autosolutionsai-didac/tiny-engineer/hardware/README.md

# Hardware (PCB)

KiCad PCB projects for Tiny Engineer.

Boards live under `boards/<board-name>/`. Prefer the same name for the directory and the KiCad project.

| Board | Role |
| --- | --- |
| [`main-control-board`](boards/main-control-board/) | Draft interconnect / carrier (header sockets for existing modules) |
| [`xiao-main-board`](boards/xiao-main-board/) | Draft carrier for the Seeed XIAO ESP32S3 build (70 × 45 mm): sockets for XIAO, PCA9685, MAX98357A, OLED, 5993 power input; buffered WS2812 output |

Contribution rules, KiCad version, what to commit, ERC/DRC, and PR expectations: [docs/pcb.md](../docs/pcb.md). Pre-PR checklist: [docs/pcb.md#checklist](../docs/pcb.md#checklist). Critical net checklist: [docs/pcb.md#expected-nets-yml](../docs/pcb.md#expected-nets-yml). Local/CI checks: `python3 scripts/check_pcb.py` (KiCad 10) — [docs/testing.md](../docs/testing.md).

This tree is KiCad source only. Robot electrical reference (pinout, wiring, BOM) is [`docs/hardware/`](../docs/hardware/README.md). Firmware drivers are `src/hardware/`.

## License

Board sources in `boards/` are [CERN-OHL-S-2.0](LICENSE). See [NOTICE](NOTICE) for copyright, Source Location, and product notice requirements.

This README is software documentation and remains under the MIT License — [LICENSING.md](../LICENSING.md).

The **Tiny Engineer** name and logo are not licensed — [TRADEMARK.md](../TRADEMARK.md).
