autosolutionsai-didac/tiny-engineer/3d_models/README.md

# 3D models

Printable parts and source CAD for the Vibe Bot desk robot, based on the Tiny Engineer open hardware design by Krzysztof Jamroz (upstream Source Location: https://github.com/jamro/tiny-engineer/tree/main/3d_models — see [NOTICE](NOTICE)).

## CAD TODO (Vibe Bot)

The CAD in this folder is still the upstream Tiny Engineer design. Before Vibe Bot ships its own printables, the following must be done **in Autodesk Fusion 360** (the `.f3d` source can only be edited there; never hand-edit `.3mf` / `.stl` / `.step` exports), then re-exported for every servo preset ([adding parts](../docs/3d/adding-parts.md), [parametric design](../docs/3d/parametric-design.md)):

- [ ] **Replace the emblem.** `AiEmblem` (all `parts/*/3mf/AiEmblem.3mf` and its body in `cad/TinyEngineer.f3d`) is upstream trademark geometry ([TRADEMARK.md](../TRADEMARK.md)). Replace it with a Vibe Bot emblem and stop shipping `AiEmblem` as this product's branding.
- [ ] **Redesign the controller slot.** The `DeskTop` / `LampBase` ESP slot is sized for the Waveshare ESP32-C3-Zero. Rework it for the **Seeed Studio XIAO ESP32S3 (21 × 17.8 mm)**, with access to the XIAO USB-C (flash / serial) and clearance around its antenna.
- [ ] **Add a slot for the LED bar.** Add a mount for the 8-LED WS2812B session bar (plus the lamp LED, the 74AHCT1G125 level shifter and the 330 Ω resistor) — see [docs/hardware/wiring.md](../docs/hardware/wiring.md#led-chain).
- [ ] **Robot power input.** Check the existing USB-C breakout mount still fits the separate 5 V / 3 A power-input USB-C, the SS14 and the 470 µF capacitor ([power.md](../docs/hardware/power.md)).
- [ ] **Optional:** rename the source file (`cad/TinyEngineer.f3d`) and the Fusion add-in ([`fusion/TinyEngineerTools/`](fusion/TinyEngineerTools/): folder, `.py` and `.manifest` must be renamed together; command names such as *Tiny Engineer Parts Exporter*) once the above is done, and update every doc link; keep the upstream attribution and CERN-OHL-S notices.

Until then, prints from `parts/` produce the upstream Tiny Engineer mechanics (C3-Zero slot, AI emblem).

## Source CAD (edit / resize)

The full assembly — all components composed — lives in [`cad/TinyEngineer.f3d`](cad/TinyEngineer.f3d) (Autodesk Fusion). Open that file to adjust the model or adapt it to different hardware sizing (e.g. different servos). Parametric servo sizes and the Fusion add-in: [docs/3d/parametric-design.md](../docs/3d/parametric-design.md).

**Adding a new part** (parametric rules, timeline, `PRINT_LAYOUT`, Servo Configurator, export, optional mods): [docs/3d/adding-parts.md](../docs/3d/adding-parts.md). Optional / community mods: [`mods/`](mods/).

## Printables

Individual parts are exported under [`parts/{servo_id}/`](parts/). Match the folder to the servos you bought ([which servo](../docs/shopping.md)). `stl/` next to `3mf/` is the same mesh in binary STL. `step/` next to those is CAD interchange (BRep STEP), not a printable mesh for a home slicer.

Two ways to get the mechanical set (same place in the build path):

- **Print yourself** — use the **`.3mf` files in `parts/sg90/3mf/`**, **`parts/fs0307/3mf/`**, or **`parts/hd1370a/3mf/`**. Ready to print in an orientation that does not need supports. **PLA** or **PETG**. Start with [Print first](#print-first).
- **No printer?** — order the aggregated sets from a third-party service: [order printed parts](../docs/3d/order-parts.md). Orders are at your own risk; fit can vary by provider and design revision.

### Print first

**Home printers only.** Print these two small testers from that folder **before** the rest of the set. Do not print the full robot until both fit. Skip this step when ordering from a service (testers alone are rarely worth the min fee + shipping).

1. **`ServoSizingTester.3mf`** — seat a real servo; do not force it. The body should slide, tabs sit, holes line up, and the shaft should have clearance. Tight or loose → sand/ream, or adjust servo CAD params ([parametric design](../docs/3d/parametric-design.md)).
2. **`ScrewSizingTest.3mf`** — M2 screw pilot-hole tolerance. Each hole is marked with its diameter. Drive an M2 screw into each hole and pick the tightest size that still cuts a thread (does not spin freely / slide through). Set Fusion user parameter `screw_thread_diameter` to that marked value, then re-export before printing structural parts. Details: [M2 screw holes](../docs/3d/parametric-design.md#m2-screw-holes).

Assembly uses **M2 screws** that thread directly into the printed PLA/PETG — no glue, no heat-set inserts. Easy to dismount and modify later. Buyer cart (electronics + screw qty + supply): [docs/shopping.md](../docs/shopping.md). Overall build order: [docs/getting-started.md](../docs/getting-started.md). Mechanical procedure: [docs/3d/assembly.md](../docs/3d/assembly.md). Per-step lengths: [screw list](#screws) below.

### Screws

**Spec:** M2 thread-forming (self-tapping) screws for plastic, **pan-head or button-head** — there are no counterbores/countersinks in any part, so heads sit on the plastic surface. CAD default pilot is **2.1 mm** (Fusion user parameter `screw_thread_diameter`); if your `ScrewSizingTest` winner differs, re-export at that diameter before printing structural parts. Details: [M2 screw holes](../docs/3d/parametric-design.md#m2-screw-holes).

**One BOM for every servo preset** (`parts/sg90/`, `parts/fs0307/`, `parts/hd1370a/`, …). Printed parts scale with the servo choice, but the lengths below are the reference list for all of them — including smaller models for smaller servos. Buy quantities: [docs/shopping.md](../docs/shopping.md). Pilots are cut as deep as practical so nearby lengths often work too; if you already have different M2 lengths, test-fit before buying a full set. Per-step placement: [assembly guide](../docs/3d/assembly.md).

**Per robot (qty is source of truth):**

| Item | Qty | Typical use |
| --- | --- | --- |
| M2×4 mm | 8 | Emblem, PCA9685, MAX98357A |
| M2×8 mm | 21 | Hat, Neck↔Head, Chest center (prefer two), Belly↔Chest, LampBase, laptop, mug, Chair↔Desk, elbows |
| M2×16 mm | 15 | Chest side servos, SeatLeft/Right, DeskTop stack, USB-C, Bell |
| M2 nuts | 6 | Neck captured ×1, USB-C ×4, Bell ×1 |
| Servo bag screws | 5 | Neck shaft, Neck↔Head (robot’s left), Belly shaft, both arms |

Prefer **two** M2×8 for the Neck servo in `Chest`; one at the back is enough if space is tight (buy 21 either way). An M2 assortment covering **M2×4–M2×16** is the easy path.

## Parts

Same filenames in each `parts/{servo_id}/3mf/` folder (and matching `stl/` / `step/`):

| File | Role |
| --- | --- |
| `PartsSetA.3mf` | Aggregated copper-color group for [service orders](../docs/3d/order-parts.md) (home print: use individuals below) |
| `PartsSetB.3mf` | Aggregated black-color group for [service orders](../docs/3d/order-parts.md) (home print: use individuals below) |
| `Head.3mf` | Head (pitch) |
| `Neck.3mf` | Neck (yaw) |
| `ForearmLeft.3mf` | Left forearm / hand |
| `ForearmRight.3mf` | Right forearm / hand |
| `UpperArm.3mf` | Upper arm |
| `Chest.3mf` | Chest / torso |
| `Belly.3mf` | Belly |
| `Chair.3mf` | Chair |
| `SeatLeft.3mf` | Left chair seat |
| `SeatRight.3mf` | Right chair seat |
| `Desk.3mf` | Desk structure |
| `DeskTop.3mf` | Desk top surface |
| `DeskPad.3mf` | Desk pad |
| `LaptopCase.3mf` | Miniature laptop body |
| `LaptopScreen.3mf` | Laptop screen |
| `Bell.3mf` | Service bell |
| `LampBase.3mf` | Desk lamp base |
| `LampCap.3mf` | Lamp cap |
| `LampDiffuser.3mf` | Lamp diffuser |
| `LampButton.3mf` | Lamp button |
| `Mug.3mf` | Mug |
| `Coffee.3mf` | Coffee fill |
| `Hat.3mf` | Hat |
| `ServoSizingTester.3mf` | Servo pocket fit tester |
| `ScrewSizingTest.3mf` | M2 screw pilot-hole diameter tester |
| `AiEmblem.3mf` | AI emblem detail — upstream Tiny Engineer trademark geometry; do not use as Vibe Bot branding (to be replaced, see [CAD TODO](#cad-todo-vibe-bot)) |

## Next steps

Return to the build checklist: [docs/getting-started.md](../docs/getting-started.md) ([§2 Print or order](../docs/getting-started.md#2-print-or-order) done). Wire and flash **before** opening the mechanical guide.

1. Wire, then flash: [docs/hardware/wiring.md](../docs/hardware/wiring.md), [docs/flash.md](../docs/flash.md)
2. Assemble in one run: [docs/3d/assembly.md](../docs/3d/assembly.md)
3. Servo axes and safe ranges: [docs/robot-movement.md](../docs/robot-movement.md)
4. Bring-up and failures: [docs/hardware/testing.md](../docs/hardware/testing.md)

## License

CAD source (`.f3d`) in [`cad/`](cad/) and printable parts (`.3mf`) in [`parts/`](parts/) are licensed under [CERN-OHL-S-2.0](LICENSE). See [NOTICE](NOTICE) for copyright, Source Location, and product notice requirements.

Commercial use is allowed. If you modify and distribute Products based on these designs, reciprocal provisions require sharing your Complete Source under the same license. This documentation file is software documentation and remains under the MIT License — see [LICENSING.md](../LICENSING.md).

The upstream **Tiny Engineer** name, logo and AI emblem are not licensed and are not Vibe Bot branding — see [TRADEMARK.md](../TRADEMARK.md).
