autosolutionsai-didac/tiny-engineer/docs/README.md

# Docs index

Pick a path. Depth lives in the linked pages.

### Building the robot

| You want to… | Start here |
| --- | --- |
| **Build from scratch** (canonical checklist) | [getting-started.md](getting-started.md) |
| **Buy parts** (one cart) | [shopping.md](shopping.md) |
| **Bridge into hardware/electronics** (software engineer background) | [hardware-for-software-engineers/README.md](hardware-for-software-engineers/README.md) — optional parallel reading; safety card lives on the checklist |
| **Assemble printed parts** (mechanical procedure) | [3d/assembly.md](3d/assembly.md) |
| **Flash firmware** | [flash.md](flash.md) |
| **Wire / power detail** | [hardware/wiring.md](hardware/wiring.md) → [hardware/README.md](hardware/README.md) |
| **Print / parts inventory** | [../3d_models/README.md](../3d_models/README.md) |
| **Order printed parts** (no 3D printer) | [3d/order-parts.md](3d/order-parts.md) |
| **Adapt CAD to a different servo** | [3d/parametric-design.md](3d/parametric-design.md) |
| **Add a new CAD / printable part** | [3d/adding-parts.md](3d/adding-parts.md) |
| **Use with an agent** (robot already on Wi-Fi) | [integration.md](integration.md) · Cursor: [hooks.md](hooks.md) |

### Reference and contribute

| You want to… | Start here |
| --- | --- |
| **Contribute a PCB** (KiCad) | [pcb.md](pcb.md) → [`hardware/`](../hardware/README.md) |
| **HTTP API / settings** | [api.md](api.md); add a setting: [settings.md](settings.md) |
| **Any IDE / scripts** | [integration.md](integration.md) |
| **Several agent sessions at once** | [sessions.md](sessions.md) |
| **Firmware / package tests** | [testing.md](testing.md) |
| **AI coding agents (repo rules)** | [AGENTS.md](../AGENTS.md) |
| **Contribute / report a vuln** | [CONTRIBUTING.md](../CONTRIBUTING.md); [SECURITY.md](../SECURITY.md) |

Also: [robot-movement.md](robot-movement.md) (servo axes and safe ranges); optional [macos-lock-unlock.md](macos-lock-unlock.md) (sleep/wake on Mac screen lock).

**Source of truth:** pin constants in firmware (`include/pins.h`); electrical detail in `docs/hardware/`; HTTP shapes in [api.md](api.md). Overall build order: [getting-started.md](getting-started.md).
