autosolutionsai-didac/tiny-engineer/3d_models/fusion/README.md

# Fusion add-in

Add-in code lives in [`TinyEngineerTools/`](TinyEngineerTools/). Folder name, `TinyEngineerTools.py`, and `TinyEngineerTools.manifest` must stay the same. These names come from the upstream Tiny Engineer project and are kept for now (a rename, done consistently across all three, is listed in the [CAD TODO](../README.md#cad-todo-vibe-bot)).

Install, servo parameters, configurator, and export: [docs/3d/parametric-design.md](../../docs/3d/parametric-design.md).
