autosolutionsai-didac/tiny-engineer/docs/api.md

# HTTP API

JSON HTTP server on the ESP32 (XIAO ESP32S3 default target; ESP32-C3-Zero legacy). Source: [`src/http/http_server.cpp`](../src/http/http_server.cpp) and handlers under [`src/http/`](../src/http/), test routes in [`src/http/test_handlers.cpp`](../src/http/test_handlers.cpp).

Listens on **port 80** after STA Wi-Fi connects, or during setup AP mode at `http://192.168.4.1/`. Base URL is the board IP (OLED / serial) or `http://vibebot.local` (mDNS, 2.4 GHz only).

Optional auth: when an `access_token` is configured in settings, all JSON API routes require `Authorization: Bearer <token>`. Empty token (default) means no auth. `GET /auth` is always public and reports whether auth is required. Missing/wrong token → **401** `{"ok":false,"error":"unauthorized"}`. HTML panel routes stay public (the UI prompts for the token). `Content-Type: application/json`. CORS: `Access-Control-Allow-Origin: *`, `Access-Control-Allow-Headers: Authorization`.

When WiFi credentials are not saved yet, control APIs (`/anim`, `/session`, `/sessions`, `/sessions/clear`, `/test/*`) return **503** `{"ok":false,"error":"wifi not configured"}`. Setup routes (`/`, `/config`, `/auth`, `/health`, `/settings`, `/setup/servo`, `/setup/led`, `/setup/audio`, `/setup/oled`) stay available on the setup AP.

If boot WiFi credentials are missing, the device opens setup AP mode (`VibeBot-XXXX`) and serves a five-step setup wizard at `/config` (servo calibration, OLED orientation, RGB LED, speaker test, then Wi-Fi). If saved credentials fail, it reopens setup AP mode. Hardware tests: [`docs/hardware/testing.md`](hardware/testing.md). How to wire this API into AI tools: [`integration.md`](integration.md).

Firmware answers mDNS A and AAAA (IPv6 link-local) so macOS does not wait 2–3s on a missing AAAA. If a client still pauses on the hostname, force IPv4 (`curl -4`). The IP on the OLED skips DNS entirely.

## Endpoints

### `GET /`

HTML endpoint index. Lists all routes plus supported parameters for `/anim`, `/settings`, `/test/servo`, `/setup/servo`, `/setup/led`, `/setup/audio`, and `/setup/oled`. Safe, no hardware side effects. Always public (no Bearer required).

Open in a browser:

```bash
curl http://vibebot.local/
```

Returns `Content-Type: text/html; charset=utf-8`.

### `GET /auth`

Whether API auth is required. Always public. Safe, no hardware side effects. Does not reveal the token.

```bash
curl http://vibebot.local/auth
```

```json
{ "ok": true, "required": false, "wifi_configured": true, "provisioning": false }
```

| Field | Meaning |
| --- | --- |
| `ok` | Always `true` on this route |
| `required` | `true` when a non-empty access token is configured |
| `wifi_configured` | `true` when WiFi credentials are saved in NVS |
| `provisioning` | `true` when the setup AP is active |

### `GET /health`

Health. Safe, no hardware side effects. Uses live `WiFi.status()`, not the boot-time flag. Requires Bearer when auth is enabled.

```bash
curl http://vibebot.local/health
curl -H "Authorization: Bearer YOUR_TOKEN" http://vibebot.local/health
```

```json
{
  "ok": true,
  "uptime_ms": 12345,
  "free_heap": 120000,
  "heap_size": 320000,
  "cpu_temp_c": 41.2,
  "wifi": {
    "connected": true,
    "ip": "192.168.1.10",
    "rssi": -42,
    "hostname": "vibebot.local"
  },
  "wifi_configured": true,
  "provisioning": false,
  "setup_ap_ssid": "",
  "setup_ap_ip": "",
  "oled": true
}
```

| Field | Meaning |
| --- | --- |
| `ok` | Always `true` on this route |
| `uptime_ms` | `millis()` since boot |
| `free_heap` | `ESP.getFreeHeap()` — bytes available for allocation |
| `heap_size` | `ESP.getHeapSize()` — total heap bytes; usage % = `(1 - free_heap / heap_size) × 100` |
| `cpu_temp_c` | ESP32-C3 on-die temperature in °C (not ambient); `null` if the sensor is unavailable |
| `wifi.connected` | `WiFi.status() == WL_CONNECTED` |
| `wifi.ip` | STA IPv4, or `""` if down |
| `wifi.rssi` | dBm, or `0` if down |
| `wifi.hostname` | mDNS name from settings (`{hostname}.local`, default `vibebot.local`) |
| `wifi_configured` | `true` when WiFi credentials are saved in NVS |
| `provisioning` | `true` when setup AP mode is active |
| `setup_ap_ssid` | Setup AP SSID when `provisioning` is true, else `""` |
| `setup_ap_ip` | Setup AP IP when `provisioning` is true (usually `192.168.4.1`), else `""` |
| `oled` | SSD1306 probed and initialized |

### `GET /settings`

Persistent settings from NVS. Safe, no hardware side effects. Developer guide for adding settings: [`settings.md`](settings.md).

```bash
curl http://vibebot.local/settings
```

```json
{
  "ok": true,
  "sleep_timeout": 10,
  "hostname": "vibebot",
  "volume": 70,
  "welcome": true,
  "serial_log": false,
  "continuous_timeout": 5,
  "loading": "progress",
  "eyes_style": "classic",
  "access_token_set": false,
  "wifi_configured": true,
  "wifi_ssid": "MyNetwork",
  "wifi_password_set": true,
  "servo_mins": [60, 40, 45, 35, 40],
  "servo_maxs": [130, 130, 135, 125, 130],
  "rgb_order": "GRB",
  "oled_rotate_180": false,
  "agentdeck": "on"
}
```

| Field | Meaning |
| --- | --- |
| `sleep_timeout` | Minutes of continuous animation `none` before OLED blanks (default **10**). Any non-idle animation keeps the device awake and restarts the idle clock when returning to `none`. Other APIs do not affect the timer. |
| `hostname` | DHCP/mDNS label without `.local` (default **`vibebot`**) |
| `volume` | Speaker gain percent for tones and WAV playback (default **70**) |
| `welcome` | Play welcome animation on boot when Wi-Fi connects (default **true**). Also enables head/neck motion during `sleep_inertia` loading |
| `serial_log` | USB serial debug logging (default **false**). When off, diagnostic `Serial` output is suppressed |
| `continuous_timeout` | Minutes a continuous animation (`typing` / `reading` / `thinking`) may run before the firmware switches to `attention` then idle (default **5**) |
| `loading` | Boot loading screen: `progress` (bar + large IP for 3 s) or `sleep_inertia` (eyes wake; no bar/IP). Default **`progress`**. Applies on **next reboot** |
| `eyes_style` | OLED eyes look: `classic` (procedural rounded eyes), `kaomoji` (animated faces), `cover` (full-half bars for an eye-hole mask), or `dots` (12×12 circles). Default **`classic`**. Applies **immediately**. Classic, cover, and dots sequences are described under [`POST /anim`](#post-anim); kaomoji face mapping is under [Kaomoji eyes](#kaomoji-eyes); cover drawing is under [Cover eyes](#cover-eyes); dots drawing is under [Dots eyes](#dots-eyes) |
| `access_token_set` | `true` when a non-empty access token is stored (secret itself is never returned) |
| `wifi_configured` | `true` when a WiFi SSID is saved |
| `wifi_ssid` | Saved network name (password is never returned) |
| `wifi_password_set` | `true` when a non-empty WiFi password is saved |
| `servo_mins` | Per-joint safe minimum degrees `[head, neck, left, right, body]` (stock defaults **60, 40, 45, 35, 40**) |
| `servo_maxs` | Per-joint safe maximum degrees (stock defaults **130, 130, 135, 125, 130**). Each max must be greater than the matching min |
| `rgb_order` | Onboard WS2812 wire-byte order (`RGB`, `RBG`, `GRB`, `GBR`, `BRG`, `BGR`). Default **`GRB`**. Survives factory reset |
| `oled_rotate_180` | OLED 180° rotation (`true` → `setRotation(2)`). Default **`false`**. Setup AP only. Survives factory reset |
| `agentdeck` | AgentDeck daemon client (`on` / `off`): browse mDNS `_agentdeck._tcp` and follow its `sessions_list` over WebSocket. Default **`on`**. Applies **immediately**; factory reset restores `on`. See [sessions.md](sessions.md) |

### `POST /settings`

Update one or more settings. Query params. Values are written to NVS. `sleep_timeout`, `volume`, `welcome`, `serial_log`, `continuous_timeout`, `eyes_style`, `access_token`, and `agentdeck` apply immediately; a changed `hostname` or `loading` takes effect on the **next reboot**. WiFi credentials (`wifi_ssid` + `wifi_password`) are accepted **only in setup AP mode**; they are **tested before save**; on success the device connects to the home network and returns `wifi_connect_success`, `wifi_ip`, and `wifi_hostname`. `hostname` may be sent with those WiFi params (same validation as Config); it is saved before the STA connect so mDNS uses the chosen name immediately. Outside setup AP → **400** `wifi setup only in AP mode`. Servo ranges (`servo_mins` + `servo_maxs`) are also **setup AP only**; they apply immediately to motion clamps. Outside setup AP → **400** `servo setup only in AP mode`. RGB LED mapping (`rgb_order`) is **setup AP only** and applies immediately to the onboard LED. Outside setup AP → **400** `rgb setup only in AP mode`. OLED rotation (`oled_rotate_180`) is **setup AP only** and applies immediately to the display. Outside setup AP → **400** `oled setup only in AP mode`. Requires Bearer when auth is enabled.

```bash
curl -X POST "http://vibebot.local/settings?sleep_timeout=2"
curl -X POST "http://vibebot.local/settings?hostname=desk-bot"
curl -X POST "http://vibebot.local/settings?volume=40"
curl -X POST "http://vibebot.local/settings?welcome=0"
curl -X POST "http://vibebot.local/settings?serial_log=1"
curl -X POST "http://vibebot.local/settings?continuous_timeout=10"
curl -X POST "http://vibebot.local/settings?loading=sleep_inertia"
curl -X POST "http://vibebot.local/settings?eyes_style=kaomoji"
curl -X POST "http://vibebot.local/settings?access_token=secret"
curl -X POST "http://vibebot.local/settings?access_token="
curl -X POST "http://vibebot.local/settings?agentdeck=off"
curl -X POST "http://192.168.4.1/settings?wifi_ssid=MyNetwork&wifi_password=secret&hostname=desk-bot"
curl -X POST "http://192.168.4.1/settings?servo_mins=60,40,45,35,40&servo_maxs=130,130,135,125,130"
curl -X POST "http://192.168.4.1/settings?rgb_order=GRB"
curl -X POST "http://192.168.4.1/settings?oled_rotate_180=1"
curl -X POST "http://vibebot.local/settings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"
```

```json
{
  "ok": true,
  "sleep_timeout": 1,
  "hostname": "desk-bot",
  "volume": 70,
  "welcome": true,
  "serial_log": false,
  "continuous_timeout": 5,
  "loading": "progress",
  "eyes_style": "classic",
  "access_token_set": true,
  "wifi_configured": true,
  "wifi_ssid": "MyNetwork",
  "wifi_password_set": true,
  "servo_mins": [60, 40, 45, 35, 40],
  "servo_maxs": [130, 130, 135, 125, 130],
  "rgb_order": "GRB",
  "oled_rotate_180": false,
  "agentdeck": "on",
  "wifi_connect_success": true,
  "wifi_ip": "192.168.1.10",
  "wifi_hostname": "desk-bot.local",
  "reboot_required": true
}
```

| Param | Type | Range |
| --- | --- | --- |
| `sleep_timeout` | integer | 1–1440 minutes (positive) |
| `hostname` | string | 1–31 chars, `[A-Za-z0-9-]`, not starting/ending with `-` |
| `volume` | integer | 0–100 percent |
| `welcome` | integer | `0` or `1` (boot welcome animation) |
| `serial_log` | integer | `0` or `1` (USB serial debug logging) |
| `continuous_timeout` | integer | 1–1440 minutes (positive) |
| `loading` | string | `progress` or `sleep_inertia` |
| `eyes_style` | string | `classic`, `kaomoji`, `cover`, or `dots` |
| `access_token` | string | 0–64 printable ASCII; empty string clears the token and disables auth |
| `wifi_ssid` | string | 1–32 chars; setup AP only; must be sent with `wifi_password` |
| `wifi_password` | string | 0–63 chars; setup AP only; empty allowed for open networks; tested before save |
| `servo_mins` | string | Five comma-separated integers `0`–`180` (`head,neck,left,right,body`); setup AP only; must be sent with `servo_maxs` |
| `servo_maxs` | string | Five comma-separated integers `0`–`180`; setup AP only; each value must be greater than the matching min |
| `rgb_order` | string | `RGB`, `RBG`, `GRB`, `GBR`, `BRG`, or `BGR`; setup AP only; default `GRB` |
| `oled_rotate_180` | integer | `0` or `1`; setup AP only; default `0` |
| `agentdeck` | string | `on` or `off` (also `1` / `0`); AgentDeck daemon client; default `on` |

At least one param required. Invalid or missing-all → **400**. WiFi params outside setup AP → **400** `wifi setup only in AP mode`. Servo range params outside setup AP → **400** `servo setup only in AP mode`. RGB order outside setup AP → **400** `rgb setup only in AP mode`. OLED rotation outside setup AP → **400** `oled setup only in AP mode`. WiFi test failure → **400** with error such as `SSID not found`, `Auth failed`, or `Timeout`. `reboot_required` is present and `true` only when the saved hostname differs from the one used at this boot. After successful WiFi save, `wifi_connect_success`, `wifi_ip`, and `wifi_hostname` are included.

### `POST /settings/reset`

Factory reset: clears the NVS `te` namespace and restores settings to compile-time defaults, including WiFi credentials. **Servo min/max, RGB LED mapping (`rgb_order`), and OLED rotation (`oled_rotate_180`) are kept.** After reset, power-cycle (or press reset) so the device reopens setup AP mode and WiFi can be configured again; the servo, screen, and LED steps are pre-filled with the saved values and can be retuned. Until reboot, credentials are cleared in NVS but the radio may still be on the previous STA network. No query params. Requires Bearer when auth is enabled. Same JSON shape as `GET /settings`; includes `reboot_required` when the boot hostname, loading screen, or saved WiFi differed from defaults before reset.

The Config web UI clears the browser-stored Bearer token and shows a one-shot gate: power-cycle the device, then join the robot WiFi shown on the OLED and open the setup wizard. It does not poll for reconnect.

```bash
curl -X POST "http://vibebot.local/settings/reset"
```

```json
{
  "ok": true,
  "sleep_timeout": 10,
  "hostname": "vibebot",
  "volume": 70,
  "welcome": true,
  "serial_log": false,
  "continuous_timeout": 5,
  "loading": "progress",
  "eyes_style": "classic",
  "access_token_set": false,
  "reboot_required": true
}
```

NVS write failure → **400** `{"ok":false,"error":"factory reset failed"}`.

### `POST /test/audio`

Plays 500 / 700 / 1000 Hz on the MAX98357A (`runSoundTest()`).

```bash
curl -X POST http://vibebot.local/test/audio
```

```json
{ "ok": true, "test": "audio" }
```

### `POST /test/audio/bell`

Plays `/bell.wav` from LittleFS (`playBell()`). Git source is [`assets/bell.wav`](../assets/bell.wav) (44100 Hz mono PCM); `pio run` copies it into `data/` for the filesystem image. After changing the asset, upload with `pio run -t upload` or `pio run -t uploadfs`. Do not edit `data/` by hand — the next build overwrites it.

```bash
curl -X POST http://vibebot.local/test/audio/bell
```

```json
{ "ok": true, "test": "bell" }
```

If the WAV is missing or unreadable, returns **500** with `{"ok":false,"error":"bell playback failed"}`.

### `POST /test/screen`

OLED demo: title, `HELLO`, X in a box (`runOledTest()`). No-op if the panel is missing.

```bash
curl -X POST http://vibebot.local/test/screen
```

```json
{ "ok": true, "test": "screen" }
```

### `POST /test/movement`

All five servos: per-joint mid → +0.5 → −0.5 → mid of the saved min/max (`runServoTest()`). Needs a strong 5 V supply — see [power.md](hardware/power.md).

```bash
curl -X POST http://vibebot.local/test/movement
```

```json
{ "ok": true, "test": "movement" }
```

### `POST /test/led`

Onboard WS2812 on GPIO10: R → G → B → white → off (`runRgbTest()`), then fades back to the current animation color (see [RGB LED](#rgb-led)).

```bash
curl -X POST http://vibebot.local/test/led
```

```json
{ "ok": true, "test": "led" }
```

### `POST /setup/servo`

Setup AP only. Slowly move one servo, or all five to 90°, using the full **0–180°** electrical range (no saved safe-range clamp). ~25°/s (`SERVO_CALIB_SPEED_DEG_S`). Used by the setup wizard for seating printed parts at 90° and for range finding. Handler blocks until the move finishes. Does **not** require Wi-Fi credentials. Outside provisioning → **400** `setup servo only in AP mode`.

Either `all=90`, or `index` + `angle`.

| Param | Type | Range |
| --- | --- | --- |
| `all` | integer | `90` (every joint to 90°) |
| `index` | integer | `0`–`4` (required with `angle` when `all` is omitted) |
| `angle` | number | `0`–`180` |

```bash
curl -X POST "http://192.168.4.1/setup/servo?all=90"
curl -X POST "http://192.168.4.1/setup/servo?index=0&angle=90"
```

```json
{ "ok": true, "setup": "servo", "index": 0, "angle": 90 }
```

Wrong params return **400** and do not move any servo:

| `error` | When |
| --- | --- |
| `setup servo only in AP mode` | Not in setup AP |
| `invalid all` | `all` present but not `90` |
| `missing index or angle` | Neither `all=90` nor both `index` and `angle` |
| `invalid index` | Non-integer `index` |
| `index out of range` | `index` outside `0`–`4` |
| `invalid angle` | Non-numeric `angle` |
| `angle out of range` | `angle` outside `0`–`180` |

After STA is up, use `POST /test/servo` (clamped to saved min/max).

### `POST /setup/led`

Setup AP only. Holds the LED so provisioning dim-blue does not clobber the preview. Does **not** require Wi-Fi credentials. Outside provisioning → **400** `setup led only in AP mode`.

Logical **color** (`R` / `G` / `B`) lights firmware red/green/blue using the saved `rgb_order`, or `rgb_order` query if sent (wizard remap preview). Wire **byte** lights that WS2812 channel order-independent (`LED_COLOR_ORDER_RGB`, that channel 255). `byte=off` or neither `color` nor `byte` releases the hold and restores dim blue. Do not send `color` and `byte` together.

| Param | Type | Range |
| --- | --- | --- |
| `color` | string | `R`, `G`, or `B` (logical; uses saved or `rgb_order`) |
| `rgb_order` | string | `RGB`, `RBG`, `GRB`, `GBR`, `BRG`, or `BGR` (optional with `color`) |
| `byte` | string | `0`, `1`, `2`, or `off` (omit or `off` releases the hold) |

```bash
curl -X POST "http://192.168.4.1/setup/led?color=R"
curl -X POST "http://192.168.4.1/setup/led?color=R&rgb_order=GRB"
curl -X POST "http://192.168.4.1/setup/led?byte=0"
curl -X POST "http://192.168.4.1/setup/led?byte=off"
```

```json
{ "ok": true, "setup": "led", "color": "R" }
```

Wrong params return **400** and do not change hold state except `off` / omitted light params:

| `error` | When |
| --- | --- |
| `setup led only in AP mode` | Not in setup AP |
| `color and byte conflict` | Both `color` and a numeric `byte` present |
| `invalid color` | `color` not `R`, `G`, or `B` |
| `invalid rgb_order` | `rgb_order` present but not a valid permutation |
| `invalid byte` | `byte` present but not an integer and not `off` |
| `byte out of range` | Integer `byte` outside `0`–`2` |

Save the labeled permutation with `POST /settings?rgb_order=GRB` (setup AP only). The saved order applies immediately to animation colors, boot status, halt blinks, and `POST /test/led`.

### `POST /setup/audio`

Setup AP only. Plays `welcome.wav` from LittleFS (`playWelcome()`, ~2.7 s). Same speaker gain as settings `volume`. No query params. Does **not** require Wi-Fi credentials. Handler blocks until playback finishes. Outside provisioning → **400** `setup audio only in AP mode`. Missing/unreadable WAV → **500** `welcome playback failed`.

```bash
curl -X POST "http://192.168.4.1/setup/audio"
```

```json
{ "ok": true, "setup": "audio" }
```

After STA is up, use `POST /test/audio/bell` (or `/test/audio` for tones).

### `POST /setup/oled`

Setup AP only. Preview OLED 180° rotation without saving. Does **not** require Wi-Fi credentials. Outside provisioning → **400** `setup oled only in AP mode`.

`rotate_180=1` applies `setRotation(2)` and draws `THIS WAY UP`. `rotate_180=0` applies `setRotation(0)` and draws the same test. Omit `rotate_180` to restore saved rotation and the provisioning join-AP text.

| Param | Type | Range |
| --- | --- | --- |
| `rotate_180` | integer | `0` or `1` (omit to restore provisioning text) |

```bash
curl -X POST "http://192.168.4.1/setup/oled?rotate_180=1"
curl -X POST "http://192.168.4.1/setup/oled"
```

```json
{ "ok": true, "setup": "oled", "rotate_180": true }
```

Wrong params return **400**:

| `error` | When |
| --- | --- |
| `setup oled only in AP mode` | Not in setup AP |
| `invalid rotate_180` | `rotate_180` present but not `0` or `1` |

Save with `POST /settings?oled_rotate_180=1` (setup AP only). The saved value applies immediately and on the next boot.

### `POST /test/servo`

Smoothly move one servo to an angle at **~140°/s** (`SERVO_MAX_SPEED_DEG_S`) from its last commanded position. Query params required. Handler blocks until the move finishes.

| Param | Type | Range |
| --- | --- | --- |
| `index` | integer | `0`–`4` |
| `angle` | number | `0`–`180` |

```bash
curl -X POST "http://vibebot.local/test/servo?index=0&angle=90"
```

```json
{ "ok": true, "test": "servo", "index": 0, "angle": 90 }
```

Wrong params return **400** and do not move any servo:

| `error` | When |
| --- | --- |
| `missing index or angle` | Either query param absent |
| `invalid index` | Non-integer `index` (e.g. `abc`, `1x`) |
| `index out of range` | `index` outside `0`–`4` |
| `invalid angle` | Non-numeric `angle` |
| `angle out of range` | `angle` outside `0`–`180` |

Assembled robot: firmware clamps to the NVS min/max from setup (stock defaults in [robot-movement.md](robot-movement.md)); this route still accepts 0–180 and clamps. For unclamped assembly moves, use setup AP `POST /setup/servo`.

### `GET /anim`

Current animation name. Default at boot: `none`. No hardware side effects.

```bash
curl http://vibebot.local/anim
```

```json
{ "ok": true, "animation": "none" }
```

| Field | Meaning |
| --- | --- |
| `animation` | `none`, `typing`, `reading`, `thinking`, `ring`, `welcome`, `attention`, `error`, `abort`, `dead`, `wakeup`, or `sleep` |

### `POST /anim`

Request an animation switch. Each animation runs at least **1s**; if the current one is shorter than that, the switch waits until the hold ends. Rapid posts during the hold keep only the **latest** request. Response `animation` is the currently playing name (may still be the old one until the hold ends). Hand moves use speed-limited servo wrappers.

| Param | Type | Values |
| --- | --- | --- |
| `name` | string | `none`, `typing`, `reading`, `thinking`, `ring`, `welcome`, `attention`, `error`, `abort`, `dead`, `wakeup`, `sleep` |

```bash
curl -X POST "http://vibebot.local/anim?name=typing"
curl -X POST "http://vibebot.local/anim?name=reading"
curl -X POST "http://vibebot.local/anim?name=thinking"
curl -X POST "http://vibebot.local/anim?name=ring"
curl -X POST "http://vibebot.local/anim?name=welcome"
curl -X POST "http://vibebot.local/anim?name=wakeup"
curl -X POST "http://vibebot.local/anim?name=sleep"
curl -X POST "http://vibebot.local/anim?name=attention"
curl -X POST "http://vibebot.local/anim?name=error"
curl -X POST "http://vibebot.local/anim?name=abort"
curl -X POST "http://vibebot.local/anim?name=dead"
curl -X POST "http://vibebot.local/anim?name=none"
```

```json
{ "ok": true, "animation": "typing" }
```

Eye detail below for `eyes_style=classic` (default). With `eyes_style=cover`, the same sequences drive full-half bars ([Cover eyes](#cover-eyes)). With `eyes_style=dots`, the same sequences drive 12×12 circles ([Dots eyes](#dots-eyes)). With `eyes_style=kaomoji`, faces follow [Kaomoji eyes](#kaomoji-eyes) instead of procedural blinks, glances, flicker, or X eyes. Servo/audio behavior is the same for every style.

| `name` | Behavior |
| --- | --- |
| `none` | Head/neck/body → mid; hands down (right `min`, left `max` — inverted scales). After all joints still for 2 s, PCA9685 PWM is full-off (servos limp; head may droop). Setup AP does not release PWM. |
| `typing` | **Continuous.** Alternating hands with randomness (15° band from hand limits). Head nods slowly on lowest 10° of head limits. Body sways ±5° around mid; neck counters opposite so head stays put. Runs until replaced, or until `continuous_timeout` triggers `attention`. Same-name re-`POST` refreshes that timeout without restarting motion. |
| `reading` | **Continuous.** Hands/body park as in `none`. Head nods on same lowest 10° band as typing, but slower. Neck sweeps ±10° around mid; right (angle down) slower than left (angle up). Occasional right-hand down-arrow bursts (1–3 presses, same 15° band as typing). Runs until replaced, or until `continuous_timeout` triggers `attention`. Same-name re-`POST` refreshes that timeout without restarting motion. |
| `thinking` | **Continuous.** Hands/body park as in `none`. Head (pitch) and neck (yaw) ease from the current pose into thinking poses (up + slight left/right). Move → pause → optional micro-adjust (sometimes chained) → pause; nearby pose drift with occasional larger shifts after ~2.2 s, more often over time. Axes stagger start/duration; no periodic sway. Runs until replaced, or until `continuous_timeout` triggers `attention`. Same-name re-`POST` refreshes that timeout without restarting motion. |
| `ring` | **One-shot** service-bell gesture; does not loop. Wind-up (body `min`, neck mid, head mid+10°, both hands `max`) → fast right-hand strike to `min+5°` with head to `min` → plays `bell.wav` once on strike (LittleFS; same `uploadfs` requirement as `/test/audio/bell`) → slower bounce to `min+20°` → return to `none` pose and stop. After completion, `GET /anim` reports `none`. |
| `welcome` | **One-shot** hello gesture synced to `welcome.wav` (~2.7 s). Right hand raises during "Hello, human.", holds through the pause, wiggles during "What are we building today?", then lowers. Head nods to mid+10° and returns. Plays automatically after successful Wi-Fi connect at boot; also via API. Requires `welcome.wav` on LittleFS (same `uploadfs` flow as `bell.wav`). After completion, `GET /anim` reports `none`. |
| `attention` | Friendly input-request gesture synced to `attention.wav` (~3.0 s, "pst... human.... you might want to take a look"). Moves into a calm prompt pose first (centered body/neck, head slightly up, right hand raised partway), waits until all servos stop, then plays audio with light neck/head/hand motion during playback (whisper hold → lean toward user → glance/point on "take a look"). **Classic eyes:** phased blink/look cues during audio. After audio ends (or if audio fails to start), holds a gentle waiting loop for **1 minute** (soft head/neck drifts plus occasional slight right-hand waves), then returns to `none`. Requires `attention.wav` on LittleFS (same `uploadfs` flow as `bell.wav`). |
| `error` | Critical task-obstacle gesture synced to `error.wav` (~2.2 s, "Uh-oh. Human, we have a problem."). Moves into an obstacle-presenting pose first (body/neck angled toward the task, head concerned/down, right hand presenting the blocker, left hand indicating task area), waits until the pose settles, then plays audio with small nervous head/neck glances during playback. After audio ends (or if audio fails to start), holds a subtle blocked loop for **1 minute**, then returns to `none`. Requires `error.wav` on LittleFS (same `uploadfs` flow as `bell.wav`). |
| `abort` | **One-shot** resigned abort gesture synced to `abort.wav` (~2.5 s, "Fine. I didn't want to finish it anyway."). Raises both hands, lifts the head, and twists the neck sideways before audio starts. During playback it shrugs, dips the head, and adds a dismissive side twist. **Classic eyes:** matching glances/squints. Requires `abort.wav` on LittleFS (same `uploadfs` flow as `bell.wav`). After completion, returns to `none` pose and `GET /anim` reports `none`. |
| `dead` | **Hold.** Out-of-power: same obstacle pose as `error`, then `dead.wav` (~3.4 s, "Insufficient resources, shutting doooooowwwwnnnn..."). **Classic eyes:** failing-display flicker (irregular heights + brief blank pulses, denser near the end of the first line); at ~1.7 s ("shutting down") eyes squeeze nearly shut (~300 ms) while head/hands collapse over **~500 ms**, hold shut briefly (~200 ms), then snap to **X X** while the drawn-out shutdown still plays. If audio fails to start, collapse immediately. Stays with X eyes and pulsing red until another animation is requested. **Cover:** same flicker and squeeze as height changes, then both halves stay black (no X). **Dots:** same flicker and squeeze as circle size, then X marks in 12×12 boxes. **Kaomoji:** Sad face (no X). Does not auto-return to `none`. Requires `dead.wav` on LittleFS. |
| `wakeup` | **One-shot** sleep-inertia wake (~5.5 s + settle), same sequence as boot `loading=sleep_inertia`. **Classic eyes:** open over 2 s (cubic ease) from closed, two blinks at 2.4 s and 3.8 s. Head rises from chin-down with a fading neck wave. Always moves head/neck/hands (API path). After completion, `GET /anim` reports `none`. Does not play welcome audio — use `welcome` for that. |
| `sleep` | **One-shot** nod-off (~2 s). Lids droop toward nearly shut (0–0.7 s) while the head barely moves, then a small resist: lids ease back toward half open as the head starts down (0.7–1.1 s). Lids then shut and the head eases to chin-down (`SLEEP_HEAD_DOWN`, same pose `wakeup` starts from) by 2.0 s. OLED blanks when the lids hit shut (`DISPLAYOFF`). **Classic, cover, dots:** that lid curve. **Kaomoji:** Sleep face during the close window, then blank. Same path as the idle `sleep_timeout`. Holds `sleep` until the head settles; then `GET /anim` reports `none` while the device stays asleep until another non-`sleep`/`none` animation wakes it. After the sleep pose is still for 2 s, PWM is full-off (same limp as `none`). |

#### Kaomoji eyes

When `eyes_style=kaomoji`, the OLED shows looping faces from the expression library (3 s / 30 frames). Mapping:

| Animation / phase | Face |
| --- | --- |
| `none` (idle) | Idle |
| `typing`, `thinking` | Thinking |
| `reading`, `attention` | Curious |
| `ring` | Surprise |
| `welcome` | Happy |
| `error` | Angry |
| `abort` | Panic |
| `wakeup` | Sleepy |
| `sleep` / sleep-close | Sleep |
| sleep-open | Idle |
| `dead` | Sad |

#### Cover eyes

When `eyes_style=cover`, each eye is a solid white rectangle filling one half of the 128×32 panel (left `x=0`, right `x=64`, width 64). Open eyes are the full 32px tall, so a mask hole of any shape over that half stays lit. Animations keep the classic pose and blink timing, but only height changes: leftover rows are black on the top and/or bottom. A blink grows both margins. A look-up leaves more black on the bottom; a look-down leaves more on the top. Horizontal glance does not move the light. The `dead` X hold paints both halves black.

#### Dots eyes

When `eyes_style=dots`, each eye is a filled circle. At the classic open height the circle’s bounding box is 12×12 px, centered on the classic eye. Diameter scales with rendered height (`12 * height / 14`), so blinks, squints, wide looks, and the `dead` flicker shrink or grow the dots. Height 0 draws nothing (full blink or sleep close). Glance, scan, and look-up/down move the circle with the classic center. The `dead` X hold draws X marks in 12×12 boxes at those centers. Diameter is capped at the 32 px panel height.

Wrong params return **400**:

| `error` | When |
| --- | --- |
| `missing name` | Query param `name` absent |
| `unknown animation` | `name` not `none`, `typing`, `reading`, `thinking`, `ring`, `welcome`, `attention`, `error`, `abort`, `dead`, `wakeup`, or `sleep` |

## Sessions

Multi-session mode: agents (via the `vibebot-hub` REST pusher or an AgentDeck daemon) report per-session state; the firmware arbitrates one animation and paints the LED bar. Background and design: [sessions.md](sessions.md). Same auth and **503** rules as `/anim`. Max **8** sessions (= LED bar length); when full, the oldest idle session is evicted (if none is idle, the least recently updated one). A session not updated for **30 min** is dropped.

### `POST /session`

Create, update, or end one session. Query params:

| Param | Type | Range |
| --- | --- | --- |
| `id` | string | 1–40 chars `[A-Za-z0-9._:-]`; required |
| `state` | string | `idle`, `working`, `waiting`, `error`, or `ended` (removes); required |
| `activity` | string | `typing`, `reading`, or `thinking` (with `working`; default `thinking`) |
| `agent` | string | 0–16 chars `[a-z0-9-]` (e.g. `claude-code`, `cursor`) |
| `label` | string | 0–24 printable ASCII chars (project name) |

`activity` only matters with `state=working`; a `working` update without `activity` keeps the session's previous activity (or `thinking` for a new one). Omitted `agent` / `label` keep their stored values. Re-posting an unchanged session is a keepalive: it refreshes the 30-min reaper but does **not** count as a state change for arbitration.

```bash
curl -X POST "http://vibebot.local/session?id=cc-1&state=working&activity=typing&agent=claude-code&label=my-project"
curl -X POST "http://vibebot.local/session?id=cc-1&state=waiting"
curl -X POST "http://vibebot.local/session?id=cc-1&state=ended"
```

```json
{ "ok": true, "slot": 0, "sessions": 1 }
```

`slot` (0–7) is the LED bar position; it stays fixed for the session's lifetime. For `state=ended` it is the slot that was freed, or `-1` if the id was unknown. **400** errors: `invalid id`, `invalid state`, `invalid activity`, `invalid agent`, `invalid label`.

### `GET /sessions`

```bash
curl http://vibebot.local/sessions
```

```json
{
  "ok": true,
  "source": "rest",
  "sessions": [
    { "id": "cc-1", "agent": "claude-code", "label": "my-project", "state": "working", "activity": "typing", "slot": 0, "age_s": 12, "source": "rest" }
  ]
}
```

| Field | Meaning |
| --- | --- |
| `source` | `agentdeck`, `rest`, `mixed` (both present), or `none` (empty table = manual mode) |
| `sessions[].state` | `idle`, `working`, `waiting`, or `error` |
| `sessions[].activity` | `typing`, `reading`, or `thinking` when `working`; empty string otherwise |
| `sessions[].slot` | LED bar position 0–7 |
| `sessions[].age_s` | Seconds since the session was last updated (any update, including keepalives) |
| `sessions[].source` | `rest` (`POST /session`) or `agentdeck` |

### `POST /sessions/clear`

Removes every REST-sourced session (AgentDeck sessions stay). No params. `vibebot-hub` sends this on startup.

```json
{ "ok": true }
```

### Arbitration

Evaluated whenever the table changes and once per second:

1. any `waiting` → `attention`
2. any `error` → `error`
3. any `working` → activity of the working session whose state/activity changed most recently (`typing` / `reading` / `thinking`)
4. a session went `working → idle` since the last evaluation → `ring` (one-shot, once per transition)
5. otherwise → `none`

`setAnimation` is only called when the target changes; a still-`working` target is re-posted every **60 s** so `continuous_timeout` does not fire. With no sessions the robot is in manual mode and `POST /anim` behaves as before (when the last session disappears while the arbiter was driving an animation, it posts `none` once). A manual `POST /anim` suspends arbitration for **15 s**; `working → idle` transitions during that window do not ring later.

## Errors

| Status | Body | When |
| --- | --- | --- |
| `400` | `{"ok":false,"error":"..."}` | Bad `/test/servo`, `/setup/servo`, `/setup/led`, `/setup/audio`, `/setup/oled`, `/anim`, or `/session` params (see tables above) |
| `401` | `{"ok":false,"error":"unauthorized"}` | Access token configured and `Authorization: Bearer` missing or wrong |
| `404` | `{"ok":false,"error":"not found"}` | Unknown path |
| `405` | `{"ok":false,"error":"method not allowed"}` | Wrong method on a `/test/*`, `/setup/servo`, `/setup/led`, `/setup/audio`, `/setup/oled`, `/settings`, `/settings/reset`, `/anim`, `/session`, `/sessions`, `/sessions/clear`, or `/auth` path |

Test routes are **POST**. GET/prefetch would move hardware. `/anim` allows **GET** (read) and **POST** (set). `/session` and `/sessions/clear` are **POST**; `/sessions` is **GET**. `/auth` is **GET** only and always public.

## Behaviour

Test handlers **block** until the test finishes. The client waits. After each test, OLED returns to `ROBOT READY` plus IP (or `WIFI FAIL`).

`/anim` responses return immediately; typing motion runs in the main loop via non-blocking servo updates. Animation switches may defer up to 1s so the active animation holds its minimum duration; only the latest pending request is applied. Continuous animations (`typing`, `reading`, `thinking`) that stay active longer than `continuous_timeout` minutes switch to `attention`, which holds ~1 minute then finishes to `none`. Re-`POST`ing the same continuous animation (e.g. `typing` while already `typing`) does not restart motion, but resets the continuous-timeout clock.

The onboard RGB LED follows the active animation (see [RGB LED](#rgb-led)).

One request at a time — the Arduino `WebServer` is single-threaded.

## RGB LED

**XIAO ESP32S3 (default):** a 9-LED WS2812B chain on **GPIO1 / D0** (`RGB_LED_PIN`, via a 74AHCT1G125 level shifter). Index **0** is the lamp LED described below; indexes **1–8** are the [session LED bar](#session-led-bar). **ESP32-C3-Zero (legacy):** the onboard WS2812 on **GPIO10**; no bar. Byte order is the saved `rgb_order` setting (default **GRB**). Animation-driven colors are handled in [`src/hardware/rgb.cpp`](../src/hardware/rgb.cpp) and switch when `POST /anim` applies a new state (same 1s minimum hold as servos/eyes).

| Animation | LED color |
| --- | --- |
| `typing`, `reading`, `thinking`, `welcome`, `ring`, `wakeup` | White (full intensity) |
| `attention`, `error`, `dead` | Red pulse: 500 ms 10%→100%, 500 ms hold 100%, 500 ms 100%→10%, repeat |
| `abort` | Red (full intensity, solid) |
| `none`, `sleep` | Off |

Transitions take **1 s** with smooth fade in/out (pulse modes start immediately, no enter fade):

- **Off ↔ color** — single 1 s fade (e.g. idle → typing fades in white; ring → `none` fades out).
- **White ↔ solid red** — fade out to black (500 ms), then fade in to the new color (500 ms).
- **Leaving pulse** — 1 s fade from the current pulse brightness to the new target.

Switching between animations that share the same color (e.g. `typing` → `reading`) does not restart a fade.

Boot uses dim green `(0, 32, 0)` as a status indicator during init. After `ROBOT READY`, the LED fades to white if `welcome` runs (Wi-Fi OK) or off if idle. Fatal PCA9685 / I2S errors hang and blink the LED red (1 = PCA9685 missing, 2 = I2S failed) — not animation-driven. See [boot-failure blink codes](hardware/testing.md#boot-failure-blink-codes).

`POST /test/led` runs a hardware colour cycle (lamp and every bar LED) and then restores the current animation LED state.

### Session LED bar

XIAO ESP32S3 only. LED `1 + slot` shows the session in that slot (`slot` from `POST /session` / `GET /sessions`). Uses the same `rgb_order`.

| Session state | Bar LED |
| --- | --- |
| empty slot | Off |
| `idle` | Dim green |
| `working` | Cyan breathing (~2 s period) |
| `waiting` | Amber fast pulse (~0.5 s period) |
| `error` | Solid red |
| just finished (`working → idle`) | 2 s bright green flash, then dim green |
