autosolutionsai-didac/tiny-engineer/docs/robot-movement.md

# Robot layout and movement

The robot sits in a chair beside a desk. A miniature laptop and a service bell sit on the desk in front of it. Five micro servos drive the pose; limits and channel IDs are in [`include/servos.h`](../include/servos.h).

| Index | Servo | Motion | At `min` | At `max` | Safe range (°) |
|---:|---|---|---|---|---|
| 0 | **Head** | Face up / down (pitch) | down | up | 60 – 130 |
| 1 | **Neck** | Head left / right (yaw) | right | left | 40 – 130 |
| 2 | **Left hand** | Hand up / down | down | up | 45 – 135 |
| 3 | **Right hand** | Hand up / down (inverted scale) | up | down | 35 – 125 |
| 4 | **Body** | Whole torso left / right | right | left | 40 – 130 |

Ranges match stock `SERVO_SPECS` in [`include/servos.h`](../include/servos.h). Those values are **defaults**. After setup AP calibration they are stored in NVS. Factory reset keeps the saved ranges. Retune them in the setup wizard when AP mode is open.

Animations author poses in **−1..1** relative to each joint’s saved min/max (`−1` = min, `0` = mid, `+1` = max). Horn offset after assembly is absorbed by calibration; firmware maps those poses with `servoNormToDeg`. Right-hand rest is still electrical min (`−1`); left-hand rest is electrical max (`+1`).

**Head** tilts the face toward or away from the laptop. **Neck** pans the head side to side. **Hands** lift and lower over the keyboard; the forearms have no elbow servo — the arm linkage is fixed, so only the hand joint moves. **Left** and **right** hand servos use opposite scales: on the left, higher angle is up; on the right, higher angle is down (rest pose for typing is left at `max`, right at `min`). **Body** rotates the whole upper body in the chair while the base stays put.

Command a single joint for bench checks:

```bash
curl -X POST "http://vibebot.local/test/servo?index=0&angle=90"
```

Use angles inside the saved safe range on the assembled robot. During setup AP, `POST /setup/servo` can command the full 0–180° electrical range so you can find those limits.

Related: [servos.md](hardware/servos.md) (PWM and electrical limits), [api.md](api.md) (`/test/servo`, `/anim`).
