autosolutionsai-didac/tiny-engineer/hardware/boards/xiao-main-board/xiao-main-board-render-bottom.png

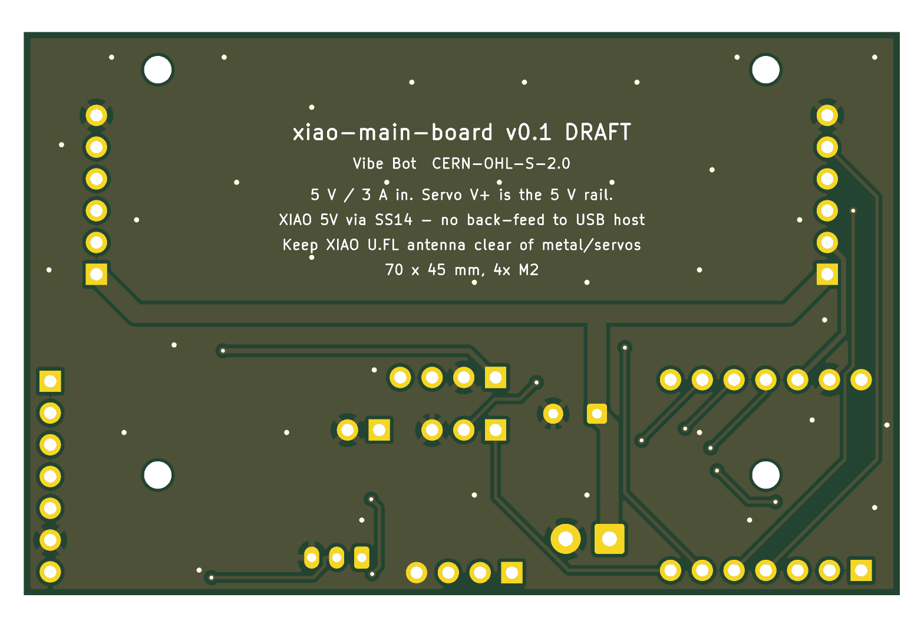
hardware/boards/xiao-main-board/xiao-main-board-render-bottom.png
