autosolutionsai-didac/tiny-engineer/docs/getting-started.md

# Getting started

Canonical build checklist for Vibe Bot. Each step: open the linked doc, finish the exit criterion, return here. Mechanical joins live in [assembly.md](3d/assembly.md); this page owns overall order.

Robot already on Wi-Fi? Jump to [step 8](#8-agent-hooks).

## Safety

Read this before you power anything. Optional *why*: [Ch. 01](hardware-for-software-engineers/01-electricity-and-units.md) and [Ch. 07](hardware-for-software-engineers/07-power-budgets-and-safety.md). Full primer is parallel reading, not a gate — [From Code to Circuits](hardware-for-software-engineers/README.md).

- Logic is **3.3 V**. Servos, the amp and the LED chain need **5 V / 3 A** on the robot's own USB-C power input (legacy C3 build: ≥ 2 A). Never power servos from the ESP32 3.3 V pin.
- PCA9685 **VCC** (logic, 3.3 V) must not short to **V+** (servo rail, 5 V).
- Every module shares **GND**.
- Speaker connects to **SPK+** and **SPK−** only. **SPK− is not ground.**
- Keep the XIAO ESP32S3 antenna (legacy: C3-Zero ceramic antenna) clear of metal and dense plastic.

## Timeline

Shop → print → wire → flash → assemble (one run) → setup wizard → prove → agent hooks.

```mermaid
flowchart LR
  shop[Shop]
  print[Print]
  wire[Wire]
  flash[Flash]
  mech[Assemble]
  wiz[Wizard]
  prove[Prove]
  agent[Agent]

  shop --> print --> wire --> flash --> mech --> wiz --> prove --> agent
```

## Checklist

### 0. Safety

- **Open:** the [Safety](#safety) card on this page.
- **Until:** you know 3.3 V vs 5 V, VCC ≠ V+, common GND, SPK− ≠ GND, and 3 A.
- **Return** here.

### 1. Shop

- **Open:** [shopping.md](shopping.md).
- **Until:** cart in hand — electronics, M2 screws/nuts, **5 V / 3 A** USB-C supply, **data** USB cable, and a print path (filament or a service order). Default servos: **Tower Pro SG90**.
- **Return** here.

### 2. Print or order

- **Open:** [3d_models/README.md](../3d_models/README.md) (home print; testers first) or [3d/order-parts.md](3d/order-parts.md) (no printer).
- **Until:** printed set for your servo model ready.
- **Return** here.

### 3. Wire

- **Open:** [hardware/wiring.md](hardware/wiring.md) and the diagram [wiring/legacy-c3-zero.drawio.png](wiring/legacy-c3-zero.drawio.png).
- **Until:** pre-power checks pass (common GND; PCA9685 **VCC** = 3.3 V vs **V+** = 5 V not shorted; OLED clock on **SCL**; speaker on **SPK+/SPK−** only). Harness stays on the desk.
- **Return** here.

### 4. Flash

- **Open:** [flash.md](flash.md).
- **Until:** firmware + LittleFS uploaded; serial boot OK; PCA9685 found; **Move all to 90°** or one `/test/servo` moves a channel. Do not finish the Wi-Fi wizard yet.
- **Return** here. Keep boards on the desk — do not seat the harness in the chest.

### 5. Assemble

- **Open:** [3d/assembly.md](3d/assembly.md) from §1 through §19 (Head/Hat, centering, joins, channels, arms, lamp).
- **Until:** all joins done; PCA9685 channels plugged per the guide.
- **Return** here.

### 6. Setup wizard

- **Open:** [3d/assembly.md §20](3d/assembly.md#20-setup-wizard-and-first-boot-on-wi-fi).
- **Until:** wizard finished, power-cycled, robot on home **2.4 GHz** Wi-Fi.
- **Return** here.

### 7. Prove it

Open `http://vibebot.local/` (or the IP on the OLED) for the web UI.

```bash
curl http://vibebot.local/health
curl -X POST "http://vibebot.local/anim?name=ring"
```

- **Until:** `/health` OK and `ring` runs (motion; sound if LittleFS uploaded). If `.local` is slow, use the OLED IP or `curl -4`.
- **Return** here. Full API: [api.md](api.md).

### 8. Agent hooks

- **Open:** [hooks.md](hooks.md) (Cursor) or [integration.md](integration.md) (Antigravity, Claude Code, raw REST).
- **Until:** optional — an agent event triggers an animation.
- Done.

## Stuck?

| Symptom | What to try |
| --- | --- |
| What to buy? | [shopping.md](shopping.md) |
| Which wires / voltages? | [hardware/wiring.md](hardware/wiring.md), [hardware/pinout.md](hardware/pinout.md) |
| What to print? | [3d_models/README.md](../3d_models/README.md) |
| How to assemble printed parts? | [3d/assembly.md](3d/assembly.md) |
| Flash / serial / LittleFS | [flash.md](flash.md) |
| `.local` slow or fails | OLED IP; `curl -4 http://…` |
| OLED shows join AP / `192.168.4.1` | Wi-Fi not saved or STA failed — finish [assembly §20](3d/assembly.md#20-setup-wizard-and-first-boot-on-wi-fi) |
| Welcome / ring silent (servos move) | LittleFS missing WAVs — `pio run -t uploadfs` ([flash.md](flash.md)) |
| Hooks never move the robot | Node 18+, hook `timeout` ≥ 30, HTTPS tarball `npx` — see [hooks.md](hooks.md) |
| Servos twitch / board resets on motion | Power budget — [hardware/power.md](hardware/power.md) |
| Other boot / I2C / audio failures | [hardware/testing.md](hardware/testing.md) |
