autosolutionsai-didac/tiny-engineer/docs/hardware/testing.md

# Hardware testing

Firmware is [`src/main.cpp`](../../src/main.cpp). Boot **inits** hardware and starts HTTP. Demos (OLED, tones, servo sweep) run on demand via REST. Helpers:

- [`src/hardware/rgb.cpp`](../../src/hardware/rgb.cpp)
- [`src/display/oled.cpp`](../../src/display/oled.cpp) (init/boot/test: `oled_init.cpp`, `oled_boot.cpp`, `oled_test.cpp`)
- [`src/network/wifi_connect.cpp`](../../src/network/wifi_connect.cpp)
- [`src/audio/audio.cpp`](../../src/audio/audio.cpp)
- [`src/hardware/pca9685_servos.cpp`](../../src/hardware/pca9685_servos.cpp)
- [`src/http/http_server.cpp`](../../src/http/http_server.cpp), [`src/http/test_handlers.cpp`](../../src/http/test_handlers.cpp)

Constants: [`include/pins.h`](../../include/pins.h). Wi-Fi credentials are saved in NVS and configured only in setup AP mode (first boot, or after factory reset + power-cycle). Servo min/max, RGB LED mapping (`rgb_order`), and OLED rotation (`oled_rotate_180`) are also setup-AP-only; factory reset keeps them.

Build/flash: [flash.md](../flash.md) (`pio run`, `pio run -t upload`, serial 115200). Default board is the **Seeed Studio XIAO ESP32S3** (PlatformIO env `xiao-esp32s3`, the default for `pio run`). The legacy **Waveshare ESP32-C3-Zero** builds with `pio run -e esp32-c3-devkitm-1`. Pins: [pinout.md](pinout.md).

## What boot covers

| Subsystem | How |
| --- | --- |
| WS2812 | Green ready on the lamp LED (XIAO: chain on GPIO1/D0, index 0; C3: onboard GPIO10) |
| I2C init | `Wire.begin` on SDA/SCL (XIAO: GPIO5/GPIO6 = D4/D5; C3: GPIO0/GPIO1) |
| PCA9685 | Probe `0x40` early; park neutral. XIAO: OE on GPIO4/D3 held HIGH (off) until PWM positions load, then LOW (enabled). C3: OE skipped (`PCA9685_OE_WIRED` is false until GP5→OE is implemented) |
| OLED | Probe `0x3C`, init (optional) |
| Wi-Fi | STA connect from saved NVS credentials, or setup AP `VibeBot-XXXX` when unset/failed; mDNS `{hostname}.local` after STA connect |
| MAX98357A / I2S | `I2S.begin` 44.1 kHz 16-bit stereo |
| Servos | Smooth move to mid (or sleep pose) at 35°/s |
| HTTP | Port 80 when STA connected, or on setup AP at `192.168.4.1` |
| Success | Dim green RGB during init; then animation LED (see below) |
| Fatal init failure | Red blink code on the WS2812 (see below) |

## Boot-failure blink codes

A fatal init failure halts boot and blinks the onboard WS2812 red. The number of
flashes before the long gap identifies the subsystem:

| Blinks | Meaning |
| --- | --- |
| 1 | PCA9685 not found on I2C `0x40` |
| 2 | MAX98357A / I2S init failed |

Each flash is 300 ms on, 300 ms off; the gap between repeats is 3 s, so the start of a
cycle is easy to find. Serial carries the same message, but the blink code is readable
with no cable attached — and with `serial_log` off (the default) the serial line is
silent, which makes the LED the only signal a first-boot board gives you.

## Expected boot sequence

1. Serial banner `VIBE BOT`
2. `Starting I2C` / `SDA = GP0` / `SCL = GP1`
3. `Checking PCA9685 at 0x40...` → **must** succeed; all channels parked at mid
4. `Checking OLED at 0x3C...` → found or `ERROR: OLED not found` (continues)
5. Settings load from NVS (`loading` = `progress` or `sleep_inertia`)
6. **Progress loading (default):** OLED progress steps (Display → WiFi → Servos → Audio → Storage → Ready), then large full-width IP (or `No IP`) for 3 s, then idle eyes
7. **Sleep inertia loading:** wakeup frame 0 during init (classic: closed lids; cover: black halves; kaomoji: Sleepy; dots: no circles). Smooth move to sleep pose if `welcome` is on. After init, wake plays from t=0: slow eye open + blinks (~5.5 s). Head/neck wave only if `welcome` is on; otherwise eyes only
8. `WIFI SETUP` on serial — connect OK + IP, open setup AP, or saved credentials failed (setup AP for reconfiguration)
9. `Starting MAX98357A` → `I2S OK`
10. `Centering servos` — smooth move to per-channel mid (progress path only; skipped if sleep pose already applied)
11. `ROBOT READY`
12. RGB fades to white over 1 s if `welcome` runs (Wi-Fi OK and setting enabled), or fades off if idle
13. If Wi-Fi OK: `HTTP: http://<ip>/`, `HTTP: http://vibebot.local/`, and `/health` URLs on serial
14. If setup AP active: `HTTP setup: http://192.168.4.1/config` on serial; OLED rotates setup instructions

`loop()` pumps the HTTP server and updates animation RGB fades. No audio/OLED/servo/LED demos until a POST.

## Animation RGB

During normal operation the lamp LED (chain index 0 on XIAO; onboard WS2812 on C3) tracks the active animation (not boot green):

| Animation | LED |
| --- | --- |
| `typing`, `reading`, `thinking`, `welcome`, `ring`, `wakeup` | White |
| `attention`, `error`, `dead` | Pulsing red (10%↔100%, 1.5 s cycle) |
| `abort` | Solid red |
| `none`, `sleep` | Off |

State changes fade over **1 s** (see [`docs/api.md`](../api.md#rgb-led)). Trigger via `POST /anim?name=…` or agent hooks / CLIs.

XIAO build: LEDs 1–8 are the session bar (dim green idle, cyan breathing working, amber pulse waiting, red error, green flash on finish). Quick check without an agent: `curl -X POST "http://vibebot.local/session?id=t1&state=working"`, then `state=idle`, then `state=ended` — see [api.md](../api.md#session-led-bar).

OLED shows matching status strings when the panel is present (progress loading: WiFi step labels; sleep inertia: eyes only).

## HTTP tests

API reference: [`docs/api.md`](../api.md).

Base URL is the board IP or `http://vibebot.local` (2.4 GHz STA). Tests have side effects — use **POST**, not GET.

```bash
# Health
curl http://vibebot.local/health

# Tones 500 / 700 / 1000 Hz
curl -X POST http://vibebot.local/test/audio

# OLED title / HELLO / X in a box
curl -X POST http://vibebot.local/test/screen

# Servos mid → +0.5 → −0.5 → mid of saved range (channels 0–4)
curl -X POST http://vibebot.local/test/movement

# WS2812 lamp (+ XIAO session bar) R → G → B → white → off, then back to current animation LED
curl -X POST http://vibebot.local/test/led

# One servo smooth move to angle (~140°/s; index 0–4, angle 0–180)
curl -X POST "http://vibebot.local/test/servo?index=0&angle=90"
```

| Method | Path | Body |
| --- | --- | --- |
| `GET` | `/` | HTML endpoint index |
| `GET` | `/auth` | Auth status (`ok`, `required`, `wifi_configured`, `provisioning`) — always public |
| `GET` | `/health` | Health JSON — full field list in [api.md](../api.md#get-health) |
| `GET` / `POST` | `/anim` | Current animation / start one (`name`, optional `interrupt`) — full params in [api.md](../api.md#post-anim) |
| `GET` | `/settings` | Persistent settings (`sleep_timeout`, `hostname`, `volume`, `welcome`, `serial_log`, `continuous_timeout`, `loading`, `eyes_style`, `access_token_set`, `wifi_configured`, `wifi_ssid`, `wifi_password_set`, `servo_mins`, `servo_maxs`, `rgb_order`, `oled_rotate_180`, `agentdeck`) |
| `POST` | `/settings?...&wifi_ssid=&wifi_password=` | Update NVS settings; WiFi params setup-AP-only and tested before save; `reboot_required` if hostname changed |
| `POST` | `/settings?...&servo_mins=&servo_maxs=` | Servo min/max comma lists; setup-AP-only |
| `POST` | `/settings?...&rgb_order=` | WS2812 byte order (`RGB`/`RBG`/`GRB`/`GBR`/`BRG`/`BGR`); setup-AP-only; default `GRB` |
| `POST` | `/settings?...&oled_rotate_180=` | OLED 180° rotation (`0`/`1`); setup-AP-only; default `0` |
| `POST` | `/settings?agentdeck=` | AgentDeck daemon client (`on`/`off`); immediate; default `on` |
| `POST` | `/session?id=&state=` | Create/update/end a session (`activity`, `agent`, `label` optional) — params in [api.md](../api.md#post-session) |
| `GET` | `/sessions` | Session table JSON (`source`, `sessions[]`) |
| `POST` | `/sessions/clear` | Remove all REST-sourced sessions |
| `POST` | `/settings/reset` | Factory reset settings to defaults (clears WiFi, keeps servo ranges, RGB mapping, and screen rotation); power-cycle to reopen setup AP |
| `POST` | `/test/audio` | `{"ok":true,"test":"audio"}` after `runSoundTest()` |
| `POST` | `/test/audio/bell` | `{"ok":true,"test":"bell"}` after `playBell()` |
| `POST` | `/test/screen` | `{"ok":true,"test":"screen"}` after `runOledTest()` |
| `POST` | `/test/movement` | `{"ok":true,"test":"movement"}` after `runServoTest()` |
| `POST` | `/test/led` | `{"ok":true,"test":"led"}` after `runRgbTest()` |
| `POST` | `/test/servo?index=&angle=` | `{"ok":true,"test":"servo","index":N,"angle":A}` after `moveServoSmooth()` |
| `POST` | `/setup/servo?all=90` or `?index=&angle=` | Setup AP only; slow 0–180° move (`SERVO_CALIB_SPEED_DEG_S`) |
| `POST` | `/setup/led?color=R` / `G` / `B` or `?byte=0` / `1` / `2` / `off` | Setup AP only; light logical RGB or one WS2812 wire byte, or release hold |
| `POST` | `/setup/audio` | Setup AP only; play `welcome.wav` (`playWelcome()`) |
| `POST` | `/setup/oled?rotate_180=0` / `1` | Setup AP only; preview OLED 180° rotation (`THIS WAY UP`); omit param to restore provisioning text |

GET on a test path returns `405`. Bad `/test/servo`, `/setup/servo`, `/setup/led`, `/setup/audio`, `/setup/oled`, `/settings`, or `/session` params return `400`. Missing/wrong Bearer when auth enabled returns `401`. Control APIs return `503` when WiFi credentials are not saved (`/setup/servo`, `/setup/led`, `/setup/audio`, and `/setup/oled` stay available). Unknown path returns `404`. JSON `Content-Type`. Handlers block until the test finishes; the OLED returns to `ROBOT READY` after.

HTTP runs on STA when connected, or on setup AP at `192.168.4.1` during provisioning.

## Failures

| Serial / OLED | Meaning | Check |
| --- | --- | --- |
| OLED `ERROR: OLED not found` then rest of boot runs | Nothing ACK’d at `0x3C` | OLED **VCC=3V3**, GND, SDA/SCL (XIAO GPIO5/6 = D4/D5; C3 GP0/GP1), common ground, address jumper still 0x3C |
| OLED found but `ERROR: OLED initialization failed` | ACK then `display.begin` failed | Wiring/power glitch, wrong size module, I2C noise |
| OLED shows `Join this WiFi` / AP name, then `Then open` / `192.168.4.1` | Setup AP mode active | Connect to the shown AP, open `http://192.168.4.1/config`, finish the servo + screen + LED + speaker + WiFi wizard |
| OLED `WiFi failed` then setup AP | Saved STA credentials failed | Join setup AP, open `http://192.168.4.1/config`, enter home WiFi again |
| `ERROR: PCA9685 not found` + red RGB + **hang** | Nothing ACK’d at `0x40` | PCA9685 **VCC=3V3** (not V+), GND, SDA/SCL, I2C address pads, +5V not required for the ACK but needed later for motion |
| `ERROR: I2S initialization failed` + red RGB + **hang** | `I2S.begin` failed | I2S pins (XIAO GPIO7/8/9 = D8/D9/D10; C3 GPIO2/3/4) not shorted to 5V/GND; pin constants; USB CDC still alive so you can read the line |
| I2S OK but `POST /test/audio` is silent | Amp or speaker | MAX98357A **Vin**=USB 5V, GND, BCLK/LRC/DIN (XIAO D8/D9/D10; C3 GP2/3/4), speaker on **SPK+ / SPK-** (not on the PNG, not GND) |
| Servos silent / twitch / ESP32 resets during `POST /test/movement` | Power or SIG | **V+** is +5V, SIG on ch 0–4, **common GND**, supply current — see [power.md](power.md) |
| RGB never goes green | LED data path | XIAO: chain data on D0/GPIO1 through the 74AHCT1G125 (5 V powered) + 330 Ω; the XIAO has no RGB LED of its own. C3-Zero: onboard LED on GPIO10 |

OLED absence and Wi-Fi failure are **soft** fails. PCA9685 and I2S failures **halt** in `while (true)`.

## Power during the servo test

All five servos move together on `POST /test/movement`. A weak USB port often dies **here**. If the serial port drops exactly when that POST runs: treat as brownout, not a PWM bug. Boot parks at each joint’s calibrated mid, which is much lighter.

## What this test does not prove

- That tuned mechanical limits match a particular physical build (start from `SERVO_SPECS`; adjust after assembly)
- BLE (out of scope)
- Speaker power rating vs max amp output
- I2C at high speed

Related: [pinout.md](pinout.md), [wiring.md](wiring.md), [servos.md](servos.md).
