autosolutionsai-didac/tiny-engineer/hardware/boards/xiao-main-board/xiao-main-board.kicad_pcb

## KiCad design hardware/boards/xiao-main-board/xiao-main-board.kicad_pcb (2026-10-18)

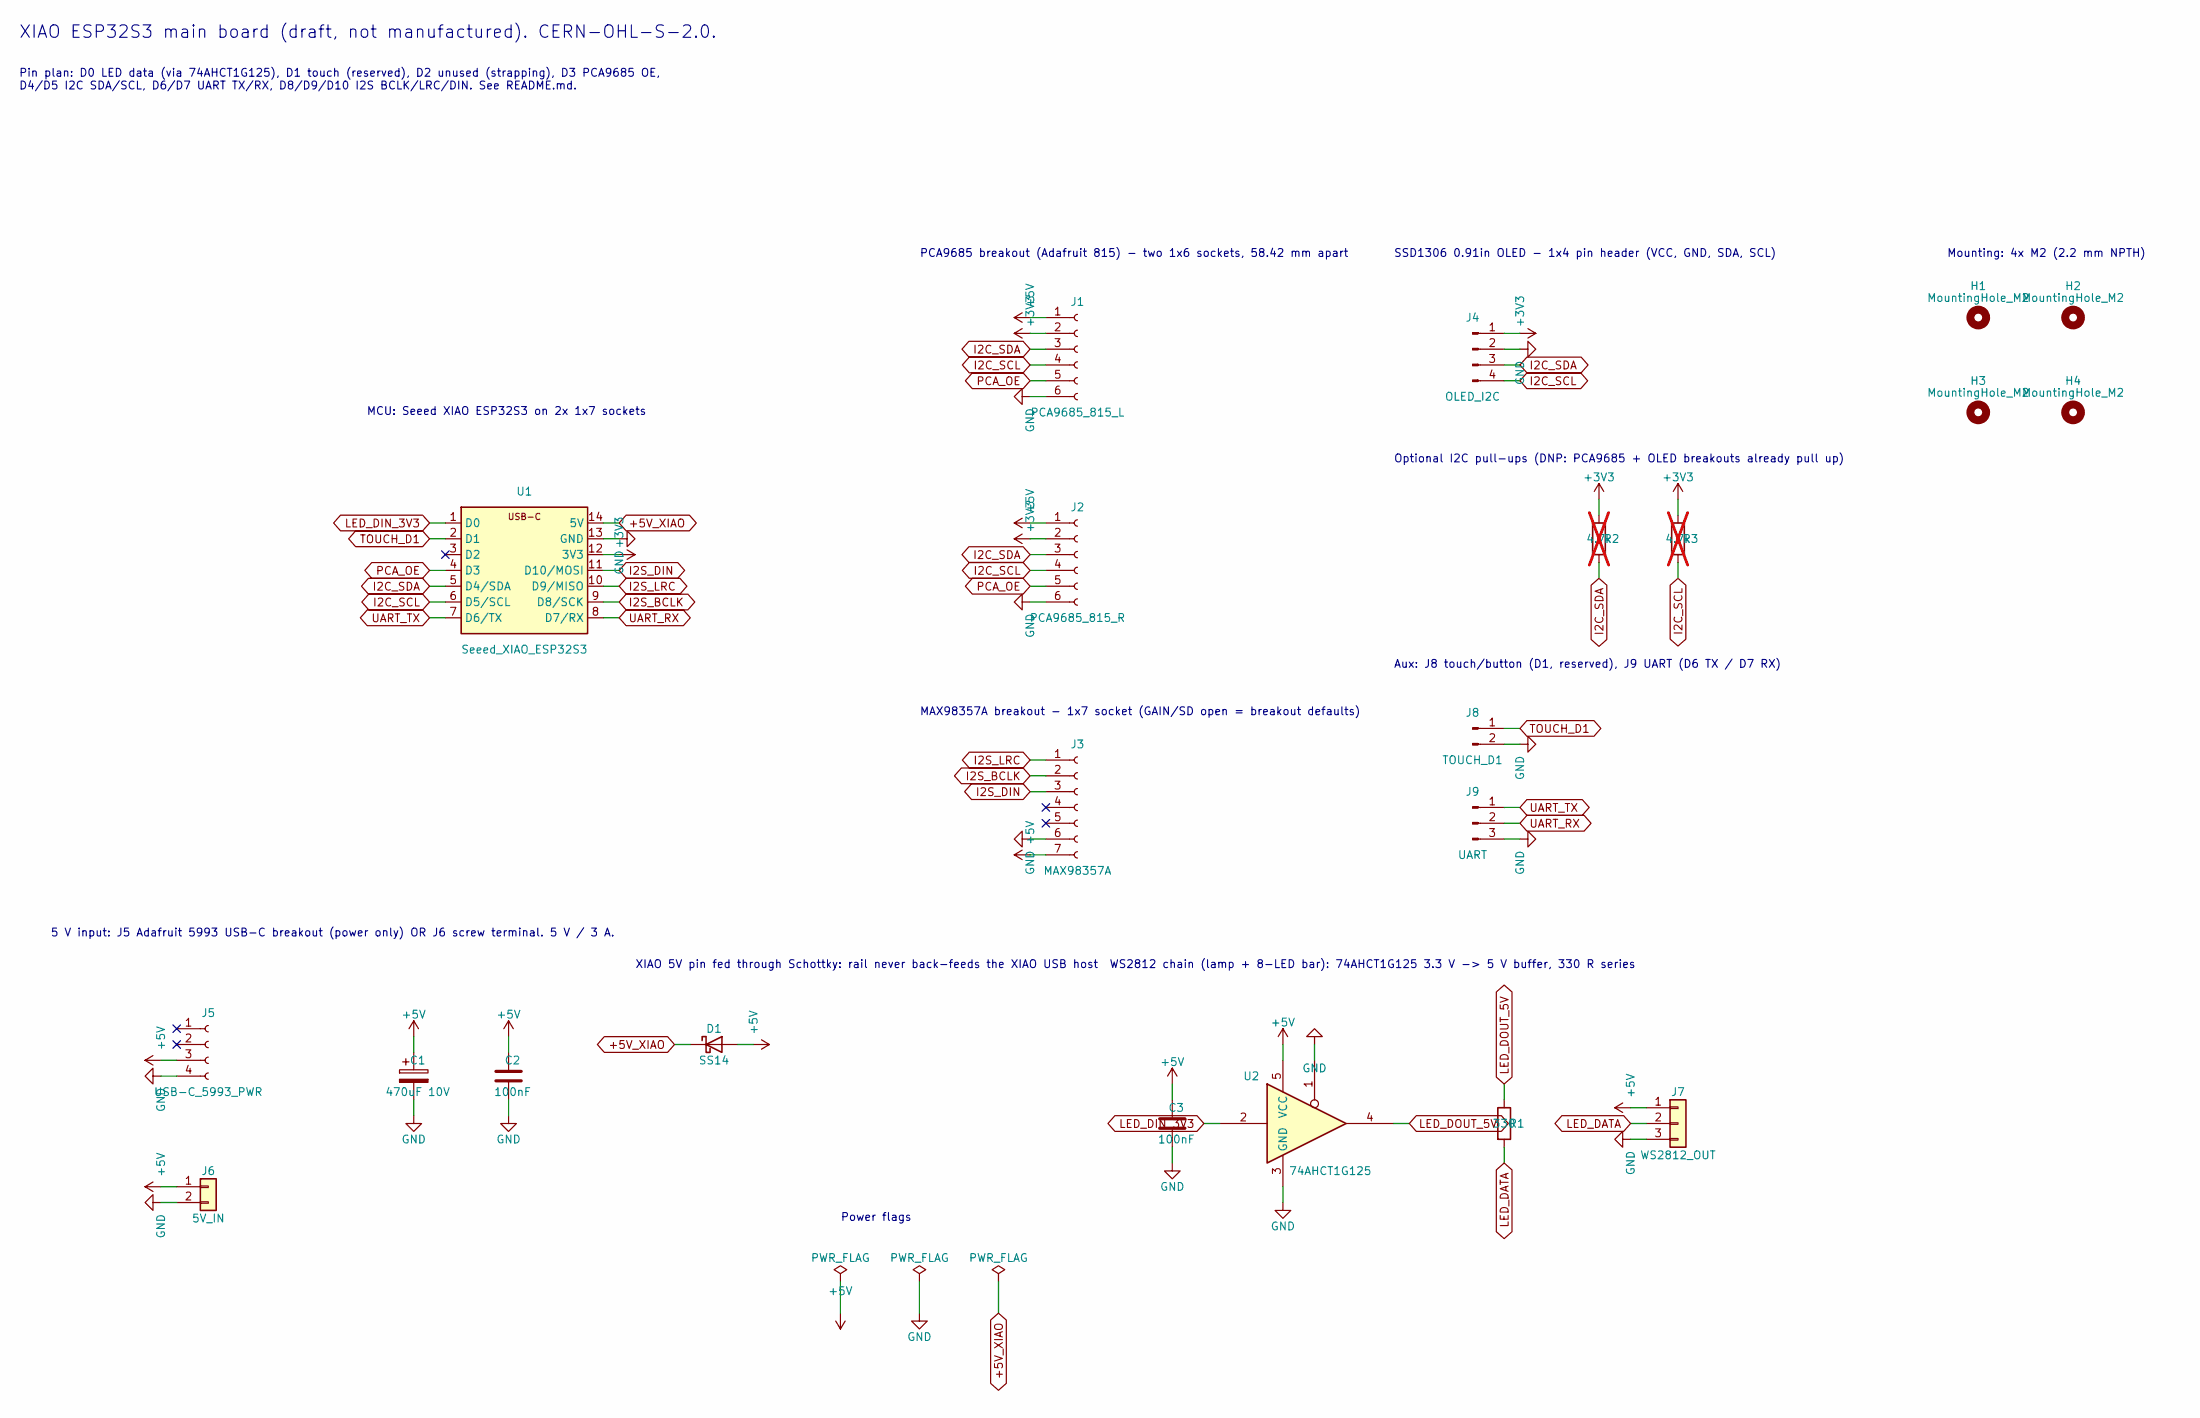
[picture p3: schematic xiao-main-board.kicad_sch, XIAO main board]

Parts:
C1: 470uF 10V; CP_Radial_D8.0mm_P3.50mm; MPN Panasonic EEU-FR1A471 (470 uF 10 V, 8x1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
C2, C3: 100nF; C_0805_2012Metric; MPN 100 nF 0805 X7R 25 V
D1: SS14; D_SMA; MPN SS14 (1 A 40 V Schottky, SMA)
H1, H2, H3, H4: MountingHole_M2; MountingHole_2.2mm_M2; MPN M2 screw + standoff
J1: PCA9685_815_L; PinSocket_1x06_P2.54mm_Vertical; MPN 1x6 female header 2.54 mm, 8.5 mm (e.g.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
J2: PCA9685_815_R; PinSocket_1x06_P2.54mm_Vertical; MPN 1x6 female header 2.54 mm, 8.5 mm (e.g.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
J3: MAX98357A; PinSocket_1x07_P2.54mm_Vertical; MPN 1x7 female header 2.54 mm, 8.5 mm (e.g.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
J4: OLED_I2C; PinHeader_1x04_P2.54mm_Vertical; MPN 1x4 male header 2.54 mm (e.g. Wurth 613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
J5: USB-C_5993_PWR; PinSocket_1x04_P2.54mm_Vertical; MPN 1x4 female header 2.54 mm (e.g. Wurth 6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
J6: 5V_IN; TerminalBlock_Phoenix_PT-1,5-2-3.5-H_1x02_P3.50mm_Horizontal; MPN Phoenix Contact PT 1,5/ 2-3,5-H (198461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
J7: WS2812_OUT; JST_PH_B3B-PH-K_1x03_P2.00mm_Vertical; MPN JST B3B-PH-K-S (mates PHR-3)
J8: TOUCH_D1; PinHeader_1x02_P2.54mm_Vertical; MPN 1x2 male header 2.54 mm
J9: UART; PinHeader_1x03_P2.54mm_Vertical; MPN 1x3 male header 2.54 mm
R1: 330; R_0805_2012Metric; MPN 330 Ohm 0805 1%
R2, R3: 4.7k; R_0805_2012Metric; MPN 4.7 kOhm 0805 1% (DNP); not fitted
U1: Seeed_XIAO_ESP32S3; Seeed_XIAO_ESP32S3_Socketed; MPN Seeed 113991114 (XIAO ESP32S3)
U2: 74AHCT1G125; SOT-23-5; MPN TI SN74AHCT1G125DBVR

Connections:
+3V3: J1.2, J2.2, J4.1, R2.1, R3.1, U1.12 (3V3)
+5V: C1.1, C2.1, C3.1, D1.2 (A), J1.1, J2.1, J3.7, J5.3, J6.1, J7.1, U2.5 (VCC)
+5V_XIAO: D1.1 (K), U1.14 (5V)
GND: C1.2, C2.2, C3.2, J1.6, J2.6, J3.6, J4.2, J5.4, J6.2, J7.3, J8.2, J9.3, U1.13 (GND), U2.1, U2.3 (GND)
I2C_SCL: J1.4, J2.4, J4.4, R3.2, U1.6 (D5/SCL)
I2C_SDA: J1.3, J2.3, J4.3, R2.2, U1.5 (D4/SDA)
I2S_BCLK: J3.2, U1.9 (D8/SCK)
I2S_DIN: J3.3, U1.11 (D10/MOSI)
I2S_LRC: J3.1, U1.10 (D9/MISO)
LED_DATA: J7.2, R1.2
LED_DIN_3V3: U1.1 (D0), U2.2
LED_DOUT_5V: R1.1, U2.4
PCA_OE: J1.5, J2.5, U1.4 (D3)
TOUCH_D1: J8.1, U1.2 (D1)
UART_RX: J9.2, U1.8 (D7/RX)
UART_TX: J9.1, U1.7 (D6/TX)

Notes on the sheet:
PCA9685 breakout (Adafruit 815) - two 1x6 sockets, 58.42 mm apart
Aux: J8 touch/button (D1, reserved), J9 UART (D6 TX / D7 RX)
MAX98357A breakout - 1x7 socket (GAIN/SD open = breakout defaults)
MCU: Seeed XIAO ESP32S3 on 2x 1x7 sockets
Mounting: 4x M2 (2.2 mm NPTH)
XIAO ESP32S3 main board (draft, not manufactured). CERN-OHL-S-2.0.
Optional I2C pull-ups (DNP: PCA9685 + OLED breakouts already pull up)
SSD1306 0.91in OLED - 1x4 pin header (VCC, GND, SDA, SCL)
5 V input: J5 Adafruit 5993 USB-C breakout (power only) OR J6 screw terminal. 5 V / 3 A.
WS2812 chain (lamp + 8-LED bar): 74AHCT1G125 3.3 V -> 5 V buffer, 330 R series
Power flags
Pin plan: D0 LED data (via 74AHCT1G125), D1 touch (reserved), D2 unused (strapping), D3 PCA9685 OE, D4/D5 I2C SDA/SCL, D6/D7 UART TX/RX, D8/D9/D10 I2S BCLK/LRC/DIN. See README.md.
XIAO 5V pin fed through Schottky: rail never back-feeds the XIAO USB host

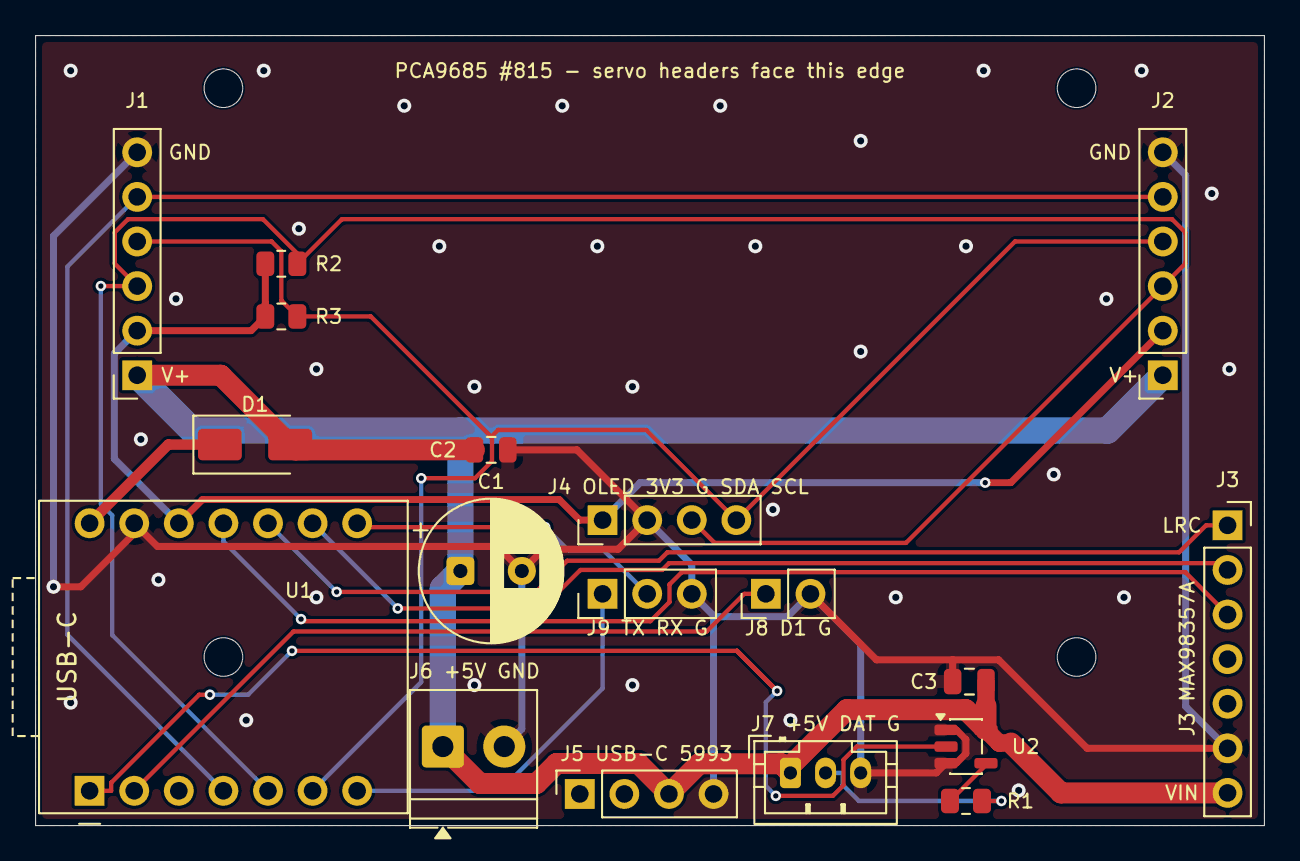
[picture p4: board xiao-main-board.kicad_pcb from above]

Board: 2 copper layers, 70.0 x 45.0 mm, 22 parts (0 on the bottom side), 16 nets.
