autosolutionsai-didac/tiny-engineer/src/http/settings_handlers.cpp

#include "http/settings_handlers.h"

#include <Arduino.h>
#include <cstdlib>
#include <cstdio>
#include <cstring>

#include "display/oled.h"
#include "http/json.h"
#include "http/server_context.h"
#include "network/wifi_connect.h"
#include "settings/settings.h"

namespace {

void formatServoRangeJson(char* dest, size_t destSize) {
  snprintf(
    dest,
    destSize,
    "\"servo_mins\":[%u,%u,%u,%u,%u],"
    "\"servo_maxs\":[%u,%u,%u,%u,%u],"
    "\"rgb_order\":\"%s\","
    "\"oled_rotate_180\":%s,"
    "\"agentdeck\":\"%s\"",
    static_cast<unsigned>(settingsServoMin(0)),
    static_cast<unsigned>(settingsServoMin(1)),
    static_cast<unsigned>(settingsServoMin(2)),
    static_cast<unsigned>(settingsServoMin(3)),
    static_cast<unsigned>(settingsServoMin(4)),
    static_cast<unsigned>(settingsServoMax(0)),
    static_cast<unsigned>(settingsServoMax(1)),
    static_cast<unsigned>(settingsServoMax(2)),
    static_cast<unsigned>(settingsServoMax(3)),
    static_cast<unsigned>(settingsServoMax(4)),
    settingsRgbOrder(),
    settingsOledRotate180() ? "true" : "false",
    settingsAgentDeckEnabled() ? "on" : "off"
  );
}

bool parseServoCsv(const String& raw, uint8_t out[SETTINGS_SERVO_COUNT]) {
  const char* p = raw.c_str();

  for (size_t i = 0; i < SETTINGS_SERVO_COUNT; i++) {
    if (p == nullptr || *p == '\0') {
      return false;
    }

    char* end = nullptr;
    const unsigned long parsed = strtoul(p, &end, 10);

    if (end == p || parsed > 255) {
      return false;
    }

    if (i + 1 < SETTINGS_SERVO_COUNT) {
      if (*end != ',') {
        return false;
      }

      p = end + 1;
    } else if (*end != '\0') {
      return false;
    }

    out[i] = static_cast<uint8_t>(parsed);
  }

  return true;
}

void sendSettingsJson(
  WebServer& server,
  bool rebootRequired,
  bool wifiConnectSuccess
) {
  char servoJson[200];
  formatServoRangeJson(servoJson, sizeof(servoJson));
  char body[1200];
  const char* tokenSet =
    settingsAccessTokenSet() ? "true" : "false";
  const char* wifiConfigured =
    settingsWifiConfigured() ? "true" : "false";
  const char* wifiPasswordSet =
    settingsWifiPasswordSet() ? "true" : "false";

  if (wifiConnectSuccess) {
    snprintf(
      body,
      sizeof(body),
      "{"
      "\"ok\":true,"
      "\"sleep_timeout\":%lu,"
      "\"hostname\":\"%s\","
      "\"volume\":%u,"
      "\"welcome\":%s,"
      "\"serial_log\":%s,"
      "\"continuous_timeout\":%lu,"
      "\"loading\":\"%s\","
      "\"eyes_style\":\"%s\","
      "\"access_token_set\":%s,"
      "\"wifi_configured\":%s,"
      "\"wifi_ssid\":\"%s\","
      "\"wifi_password_set\":%s,"
      "%s,"
      "\"wifi_connect_success\":true,"
      "\"wifi_ip\":\"%s\","
      "\"wifi_hostname\":\"%s\""
      "%s"
      "}",
      (unsigned long)settingsSleepTimeoutMin(),
      settingsHostname(),
      static_cast<unsigned>(settingsVolume()),
      settingsWelcomeEnabled() ? "true" : "false",
      settingsSerialLogEnabled() ? "true" : "false",
      (unsigned long)settingsContinuousTimeoutMin(),
      settingsLoading(),
      settingsEyesStyle(),
      tokenSet,
      wifiConfigured,
      settingsWifiSsid(),
      wifiPasswordSet,
      servoJson,
      wifiIpText(),
      httpMdnsHostname(),
      rebootRequired ? ",\"reboot_required\":true" : ""
    );
  } else if (rebootRequired) {
    snprintf(
      body,
      sizeof(body),
      "{"
      "\"ok\":true,"
      "\"sleep_timeout\":%lu,"
      "\"hostname\":\"%s\","
      "\"volume\":%u,"
      "\"welcome\":%s,"
      "\"serial_log\":%s,"
      "\"continuous_timeout\":%lu,"
      "\"loading\":\"%s\","
      "\"eyes_style\":\"%s\","
      "\"access_token_set\":%s,"
      "\"wifi_configured\":%s,"
      "\"wifi_ssid\":\"%s\","
      "\"wifi_password_set\":%s,"
      "%s,"
      "\"reboot_required\":true"
      "}",
      (unsigned long)settingsSleepTimeoutMin(),
      settingsHostname(),
      static_cast<unsigned>(settingsVolume()),
      settingsWelcomeEnabled() ? "true" : "false",
      settingsSerialLogEnabled() ? "true" : "false",
      (unsigned long)settingsContinuousTimeoutMin(),
      settingsLoading(),
      settingsEyesStyle(),
      tokenSet,
      wifiConfigured,
      settingsWifiSsid(),
      wifiPasswordSet,
      servoJson
    );
  } else {
    snprintf(
      body,
      sizeof(body),
      "{"
      "\"ok\":true,"
      "\"sleep_timeout\":%lu,"
      "\"hostname\":\"%s\","
      "\"volume\":%u,"
      "\"welcome\":%s,"
      "\"serial_log\":%s,"
      "\"continuous_timeout\":%lu,"
      "\"loading\":\"%s\","
      "\"eyes_style\":\"%s\","
      "\"access_token_set\":%s,"
      "\"wifi_configured\":%s,"
      "\"wifi_ssid\":\"%s\","
      "\"wifi_password_set\":%s,"
      "%s"
      "}",
      (unsigned long)settingsSleepTimeoutMin(),
      settingsHostname(),
      static_cast<unsigned>(settingsVolume()),
      settingsWelcomeEnabled() ? "true" : "false",
      settingsSerialLogEnabled() ? "true" : "false",
      (unsigned long)settingsContinuousTimeoutMin(),
      settingsLoading(),
      settingsEyesStyle(),
      tokenSet,
      wifiConfigured,
      settingsWifiSsid(),
      wifiPasswordSet,
      servoJson
    );
  }

  httpSendJson(server, 200, body);
}

}  // namespace

void handleSettingsGet(WebServer& server) {
  sendSettingsJson(server, false, false);
}

void handleSettingsPost(WebServer& server) {
  const bool hasSleep = server.hasArg("sleep_timeout");
  const bool hasHost = server.hasArg("hostname");
  const bool hasVolume = server.hasArg("volume");
  const bool hasWelcome = server.hasArg("welcome");
  const bool hasSerialLog = server.hasArg("serial_log");
  const bool hasContTo = server.hasArg("continuous_timeout");
  const bool hasLoading = server.hasArg("loading");
  const bool hasEyesStyle = server.hasArg("eyes_style");
  const bool hasAccessToken = server.hasArg("access_token");
  const bool hasWifiSsid = server.hasArg("wifi_ssid");
  const bool hasWifiPassword = server.hasArg("wifi_password");
  const bool hasServoMins = server.hasArg("servo_mins");
  const bool hasServoMaxs = server.hasArg("servo_maxs");
  const bool hasRgbOrder = server.hasArg("rgb_order");
  const bool hasOledRotate180 = server.hasArg("oled_rotate_180");
  const bool hasAgentDeck = server.hasArg("agentdeck");

  if (!hasSleep && !hasHost && !hasVolume && !hasWelcome && !hasSerialLog &&
      !hasContTo && !hasLoading && !hasEyesStyle && !hasAccessToken &&
      !hasWifiSsid && !hasWifiPassword && !hasServoMins && !hasServoMaxs &&
      !hasRgbOrder && !hasOledRotate180 && !hasAgentDeck) {
    httpSendJson(
      server,
      400,
      "{\"ok\":false,\"error\":\"missing sleep_timeout, hostname, volume, welcome, serial_log, continuous_timeout, loading, eyes_style, access_token, wifi_ssid, wifi_password, servo_mins, servo_maxs, rgb_order, oled_rotate_180, or agentdeck\"}"
    );
    return;
  }

  uint32_t sleepTimeoutMin = 0;
  const uint32_t* sleepPtr = nullptr;
  String hostnameArg;
  const char* hostPtr = nullptr;
  uint8_t volume = 0;
  const uint8_t* volumePtr = nullptr;
  bool welcome = false;
  const bool* welcomePtr = nullptr;
  bool serialLog = false;
  const bool* serialLogPtr = nullptr;
  uint32_t continuousTimeoutMin = 0;
  const uint32_t* contToPtr = nullptr;
  String loadingArg;
  const char* loadingPtr = nullptr;
  String eyesStyleArg;
  const char* eyesStylePtr = nullptr;
  String accessTokenArg;
  const char* accessTokenPtr = nullptr;
  String wifiSsidArg;
  const char* wifiSsidPtr = nullptr;
  String wifiPasswordArg;
  const char* wifiPasswordPtr = nullptr;
  uint8_t servoMins[SETTINGS_SERVO_COUNT] = {};
  uint8_t servoMaxs[SETTINGS_SERVO_COUNT] = {};
  const uint8_t* servoMinsPtr = nullptr;
  const uint8_t* servoMaxsPtr = nullptr;
  String rgbOrderArg;
  const char* rgbOrderPtr = nullptr;
  bool oledRotate180 = false;
  const bool* oledRotate180Ptr = nullptr;
  bool agentdeck = SETTINGS_DEFAULT_AGENTDECK;
  const bool* agentdeckPtr = nullptr;
  bool wifiConnectSuccess = false;

  if (hasSleep) {
    const String sleepArg = server.arg("sleep_timeout");
    char* end = nullptr;
    const unsigned long parsed =
      strtoul(sleepArg.c_str(), &end, 10);

    if (end == sleepArg.c_str() || *end != '\0') {
      httpSendJson(
        server,
        400,
        "{\"ok\":false,\"error\":\"invalid sleep_timeout\"}"
      );
      return;
    }

    sleepTimeoutMin = static_cast<uint32_t>(parsed);

    if (!settingsValidateSleepTimeout(sleepTimeoutMin)) {
      httpSendJson(
        server,
        400,
        "{\"ok\":false,\"error\":\"sleep_timeout out of range\"}"
      );
      return;
    }

    sleepPtr = &sleepTimeoutMin;
  }

  if (hasHost) {
    hostnameArg = server.arg("hostname");
    hostPtr = hostnameArg.c_str();

    if (!settingsValidateHostname(hostPtr)) {
      httpSendJson(
        server,
        400,
        "{\"ok\":false,\"error\":\"invalid hostname\"}"
      );
      return;
    }
  }

  if (hasVolume) {
    const String volumeArg = server.arg("volume");
    char* end = nullptr;
    const unsigned long parsed =
      strtoul(volumeArg.c_str(), &end, 10);

    if (end == volumeArg.c_str() || *end != '\0' || parsed > 255) {
      httpSendJson(
        server,
        400,
        "{\"ok\":false,\"error\":\"invalid volume\"}"
      );
      return;
    }

    volume = static_cast<uint8_t>(parsed);

    if (!settingsValidateVolume(volume)) {
      httpSendJson(
        server,
        400,
        "{\"ok\":false,\"error\":\"volume out of range\"}"
      );
      return;
    }

    volumePtr = &volume;
  }

  if (hasWelcome) {
    const String welcomeArg = server.arg("welcome");
    char* end = nullptr;
    const unsigned long parsed =
      strtoul(welcomeArg.c_str(), &end, 10);

    if (end == welcomeArg.c_str() || *end != '\0' || parsed > 1) {
      httpSendJson(
        server,
        400,
        "{\"ok\":false,\"error\":\"invalid welcome\"}"
      );
      return;
    }

    welcome = parsed == 1;
    welcomePtr = &welcome;
  }

  if (hasSerialLog) {
    const String serialLogArg = server.arg("serial_log");
    char* end = nullptr;
    const unsigned long parsed =
      strtoul(serialLogArg.c_str(), &end, 10);

    if (end == serialLogArg.c_str() || *end != '\0' || parsed > 1) {
      httpSendJson(
        server,
        400,
        "{\"ok\":false,\"error\":\"invalid serial_log\"}"
      );
      return;
    }

    serialLog = parsed == 1;
    serialLogPtr = &serialLog;
  }

  if (hasContTo) {
    const String contArg = server.arg("continuous_timeout");
    char* end = nullptr;
    const unsigned long parsed =
      strtoul(contArg.c_str(), &end, 10);

    if (end == contArg.c_str() || *end != '\0') {
      httpSendJson(
        server,
        400,
        "{\"ok\":false,\"error\":\"invalid continuous_timeout\"}"
      );
      return;
    }

    continuousTimeoutMin = static_cast<uint32_t>(parsed);

    if (!settingsValidateContinuousTimeout(continuousTimeoutMin)) {
      httpSendJson(
        server,
        400,
        "{\"ok\":false,\"error\":\"continuous_timeout out of range\"}"
      );
      return;
    }

    contToPtr = &continuousTimeoutMin;
  }

  if (hasLoading) {
    loadingArg = server.arg("loading");
    loadingPtr = loadingArg.c_str();

    if (!settingsValidateLoading(loadingPtr)) {
      httpSendJson(
        server,
        400,
        "{\"ok\":false,\"error\":\"invalid loading\"}"
      );
      return;
    }
  }

  if (hasEyesStyle) {
    eyesStyleArg = server.arg("eyes_style");
    eyesStylePtr = eyesStyleArg.c_str();

    if (!settingsValidateEyesStyle(eyesStylePtr)) {
      httpSendJson(
        server,
        400,
        "{\"ok\":false,\"error\":\"invalid eyes_style\"}"
      );
      return;
    }
  }

  if (hasAccessToken) {
    accessTokenArg = server.arg("access_token");
    accessTokenPtr = accessTokenArg.c_str();

    if (!settingsValidateAccessToken(accessTokenPtr)) {
      httpSendJson(
        server,
        400,
        "{\"ok\":false,\"error\":\"invalid access_token\"}"
      );
      return;
    }
  }

  if (hasWifiSsid || hasWifiPassword) {
    if (!wifiProvisioningMode()) {
      httpSendJson(
        server,
        400,
        "{\"ok\":false,\"error\":\"wifi setup only in AP mode\"}"
      );
      return;
    }

    if (!hasWifiSsid || !hasWifiPassword) {
      httpSendJson(
        server,
        400,
        "{\"ok\":false,\"error\":\"wifi_ssid and wifi_password required together\"}"
      );
      return;
    }

    wifiSsidArg = server.arg("wifi_ssid");
    wifiPasswordArg = server.arg("wifi_password");
    wifiSsidPtr = wifiSsidArg.c_str();
    wifiPasswordPtr = wifiPasswordArg.c_str();

    if (!settingsValidateWifiSsid(wifiSsidPtr)) {
      httpSendJson(
        server,
        400,
        "{\"ok\":false,\"error\":\"invalid wifi_ssid\"}"
      );
      return;
    }

    if (!settingsValidateWifiPassword(wifiPasswordPtr)) {
      httpSendJson(
        server,
        400,
        "{\"ok\":false,\"error\":\"wifi_password too long\"}"
      );
      return;
    }

    if (!wifiTestCredentials(wifiSsidPtr, wifiPasswordPtr, hostPtr)) {
      char body[96];
      snprintf(
        body,
        sizeof(body),
        "{\"ok\":false,\"error\":\"%s\"}",
        wifiLastConnectError()
      );
      httpSendJson(server, 400, body);
      return;
    }

    wifiConnectSuccess = true;
    wifiSsidPtr = wifiSsidArg.c_str();
    wifiPasswordPtr = wifiPasswordArg.c_str();
  }

  if (hasServoMins || hasServoMaxs) {
    if (!wifiProvisioningMode()) {
      httpSendJson(
        server,
        400,
        "{\"ok\":false,\"error\":\"servo setup only in AP mode\"}"
      );
      return;
    }

    if (!hasServoMins || !hasServoMaxs) {
      httpSendJson(
        server,
        400,
        "{\"ok\":false,\"error\":\"servo_mins and servo_maxs required together\"}"
      );
      return;
    }

    if (!parseServoCsv(server.arg("servo_mins"), servoMins) ||
        !parseServoCsv(server.arg("servo_maxs"), servoMaxs)) {
      httpSendJson(
        server,
        400,
        "{\"ok\":false,\"error\":\"invalid servo_mins or servo_maxs\"}"
      );
      return;
    }

    if (!settingsValidateServoRanges(servoMins, servoMaxs)) {
      httpSendJson(
        server,
        400,
        "{\"ok\":false,\"error\":\"servo ranges out of range\"}"
      );
      return;
    }

    servoMinsPtr = servoMins;
    servoMaxsPtr = servoMaxs;
  }

  if (hasRgbOrder) {
    if (!wifiProvisioningMode()) {
      httpSendJson(
        server,
        400,
        "{\"ok\":false,\"error\":\"rgb setup only in AP mode\"}"
      );
      return;
    }

    rgbOrderArg = server.arg("rgb_order");

    if (!settingsValidateRgbOrder(rgbOrderArg.c_str())) {
      httpSendJson(
        server,
        400,
        "{\"ok\":false,\"error\":\"invalid rgb_order\"}"
      );
      return;
    }

    rgbOrderPtr = rgbOrderArg.c_str();
  }

  if (hasOledRotate180) {
    if (!wifiProvisioningMode()) {
      httpSendJson(
        server,
        400,
        "{\"ok\":false,\"error\":\"oled setup only in AP mode\"}"
      );
      return;
    }

    const String oledArg = server.arg("oled_rotate_180");
    char* end = nullptr;
    const unsigned long parsed =
      strtoul(oledArg.c_str(), &end, 10);

    if (end == oledArg.c_str() || *end != '\0' || parsed > 1) {
      httpSendJson(
        server,
        400,
        "{\"ok\":false,\"error\":\"invalid oled_rotate_180\"}"
      );
      return;
    }

    oledRotate180 = parsed == 1;
    oledRotate180Ptr = &oledRotate180;
  }

  if (hasAgentDeck) {
    if (!settingsParseAgentDeck(server.arg("agentdeck").c_str(), &agentdeck)) {
      httpSendJson(
        server,
        400,
        "{\"ok\":false,\"error\":\"invalid agentdeck\"}"
      );
      return;
    }

    agentdeckPtr = &agentdeck;
  }

  bool rebootRequired = false;

  if (!saveSettings(
        sleepPtr,
        hostPtr,
        volumePtr,
        welcomePtr,
        serialLogPtr,
        contToPtr,
        loadingPtr,
        eyesStylePtr,
        accessTokenPtr,
        wifiSsidPtr,
        wifiPasswordPtr,
        servoMinsPtr,
        servoMaxsPtr,
        rgbOrderPtr,
        oledRotate180Ptr,
        agentdeckPtr,
        &rebootRequired
      )) {
    if (wifiConnectSuccess) {
      wifiRestoreProvisioningAp();
    }

    httpSendJson(
      server,
      400,
      "{\"ok\":false,\"error\":\"save failed\"}"
    );
    return;
  }

  refreshMdnsHostname();

  if (oledRotate180Ptr != nullptr) {
    applyOledRotation();
    restoreProvisioningOled();
  }

  sendSettingsJson(server, rebootRequired, wifiConnectSuccess);

  if (wifiConnectSuccess) {
    delay(300);
    wifiStopProvisioningAp();
    showBootIp(wifiIpText());
  }
}

void handleSettingsReset(WebServer& server) {
  bool rebootRequired = false;

  if (!factoryResetSettings(&rebootRequired)) {
    httpSendJson(
      server,
      400,
      "{\"ok\":false,\"error\":\"factory reset failed\"}"
    );
    return;
  }

  sendSettingsJson(server, rebootRequired, false);
}

bool isSettingsOrAnimPath(const String& uri) {
  return uri == "/anim" || uri == "/settings" || uri == "/settings/reset" ||
         uri == "/auth" || uri == "/setup/servo";
}
