autosolutionsai-didac/tiny-engineer/src/settings/internal.h

#pragma once

#include <cstdint>

#include "settings/settings.h"

extern uint32_t g_sleepTimeoutMin;
extern char g_hostname[SETTINGS_HOSTNAME_MAX_LEN + 1];
extern char g_bootHostname[SETTINGS_HOSTNAME_MAX_LEN + 1];
extern uint8_t g_volume;
extern bool g_welcome;
extern bool g_serialLog;
extern uint32_t g_continuousTimeoutMin;
extern char g_loading[SETTINGS_LOADING_MAX_LEN + 1];
extern char g_eyesStyle[SETTINGS_EYES_STYLE_MAX_LEN + 1];
extern char g_accessToken[SETTINGS_ACCESS_TOKEN_MAX_LEN + 1];
extern char g_wifiSsid[SETTINGS_WIFI_SSID_MAX_LEN + 1];
extern char g_wifiPassword[SETTINGS_WIFI_PASSWORD_MAX_LEN + 1];
extern uint8_t g_servoMin[SETTINGS_SERVO_COUNT];
extern uint8_t g_servoMax[SETTINGS_SERVO_COUNT];
extern char g_rgbOrder[SETTINGS_RGB_ORDER_MAX_LEN + 1];
extern bool g_oledRotate180;
extern bool g_agentdeck;

void setHostnameCache(char* dest, const char* src);
void setLoadingCache(char* dest, const char* src);
void setEyesStyleCache(char* dest, const char* src);
void setAccessTokenCache(char* dest, const char* src);
void setWifiSsidCache(char* dest, const char* src);
void setWifiPasswordCache(char* dest, const char* src);
void setRgbOrderCache(char* dest, const char* src);
void logAccessTokenState();
void logSettingsSnapshot(const char* prefix);
