autosolutionsai-didac/tiny-engineer/(commit log)

2026-10-18 feat(firmware)!: port to XIAO ESP32S3 with multi-session LED bar
    New default env xiao-esp32s3 (8 MB flash, PSRAM, dual OTA layout); the
    ESP32-C3-Zero env stays as a legacy target. Adds a session table fed by
    POST /session (vibebot-hub) or an AgentDeck daemon over mDNS/WebSocket,
    an arbiter that drives the face from the most urgent session, and a
    WS2812 chain (lamp + 8-LED session bar) on the S3. New setting agentdeck.
    BREAKING CHANGE: default build target and pin map change to the Seeed
    XIAO ESP32S3; build the esp32-c3-devkitm-1 env for existing robots.
    Claude-Session: https://claude.ai/code/session_01Jn2HERZ1vMbQM95WP9XxHH
    [partitions_8mb.csv]
2026-10-18 feat(docs)!: rebrand fork as Vibe Bot
    Rename product strings, default hostname (vibebot.local), setup AP
    (VibeBot-XXXX), hook packages (vibebot-*), docs and hardware guides for
    the XIAO ESP32S3 build. Upstream attribution, copyright and licence
    notices are kept per TRADEMARK.md.
    BREAKING CHANGE: hook packages are renamed to vibebot-cursor,
    vibebot-claude-code and vibebot-antigravity, and the default robot URL
    is http://vibebot.local. TINY_ENGINEER_URL and TINY_ENGINEER_TOKEN are
    still read as deprecated fallbacks.
    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
2026-10-18 feat(pcb): add xiao-main-board for the XIAO ESP32S3
    70 x 45 mm 2-layer socket carrier: XIAO ESP32S3, PCA9685 and MAX98357A
    sockets, OLED header, 5 V input (5993 breakout or screw terminal) with
    SS14 into the XIAO 5V pin, 470 uF servo bulk cap, and a 74AHCT1G125
    level-shifted WS2812 output for the lamp + session LED bar.
    ERC/DRC clean and netlist matches expected-nets.yml. Not manufactured.
    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
    [xiao-main-board.kicad_pcb, xiao-main-board.kicad_sch]
