autosolutionsai-didac/tiny-engineer/(notices)

Notices in the files:
hardware/boards/xiao-main-board/xiao-main-board.kicad_pcb:
Vibe Bot CERN-OHL-S-2.0
